ahmetfurkangursoy/EE464-TermProject/PCB/Altium.md

The PCB of the converter is designed via Altium Designer
