ahmetfurkangursoy/EE464-TermProject/Backflyp.PPTX

## BACKFLYP

Md Shazid Hasan - 1824572
Ahmet Furkan Gürsoy - 2375061

## Why Flyback

- Good Isolation
- Wide Input Range
- High Efficiency
- Fewer Component Comparing Other Topologies
- Many Design Guides

## Design Parameters

V_(Qmax) =V_(RO) + V_(in,max)
V_(RO) =V_(Qmax) − V_(in,max)
V_(RO) =42−18=24V
V_(RO) =(N_1)/(N_2)∗V_(out) →(N_1)/(N_2)=1/2

## Slide 4

- L_p =(V_(in,min)^2 ∗D_(max)^2 ∗eff)/(2∗P_(out) ∗f_(sw))=((12∗0.5)^2 ∗0.9)/(2∗48∗60kHz)=5.625 μH
- I_(p,peak) =(V_(in) ∗D_(max))/(L_p ∗f_(sw))=(12∗0.5)/(5.625μ∗60k)=17.78 A
- I_(p,rms) =17.78∗√(0.5/3)=7.26 A
- I_(s,peak) =17.78/2=8.89 A
- I_(s,rms) =8.89∗√(0.5/3)=3.63 A

## Magnetic Design

J_(rms) =5A/(mm^2) B_(sat) =0.2 T k_(cu) =0.3
WaAc=48/(2∗0.3∗5∗0.2∗60k)∗100=0.133 cm^4
- 00K2510E090 Core Values;
A_w =77.8 mm^2 A_e =38.5 mm^2
WaAc=77.8 mm^2 ∗ 38.5 mm^2 =0.3 cm^4

## Slide 6

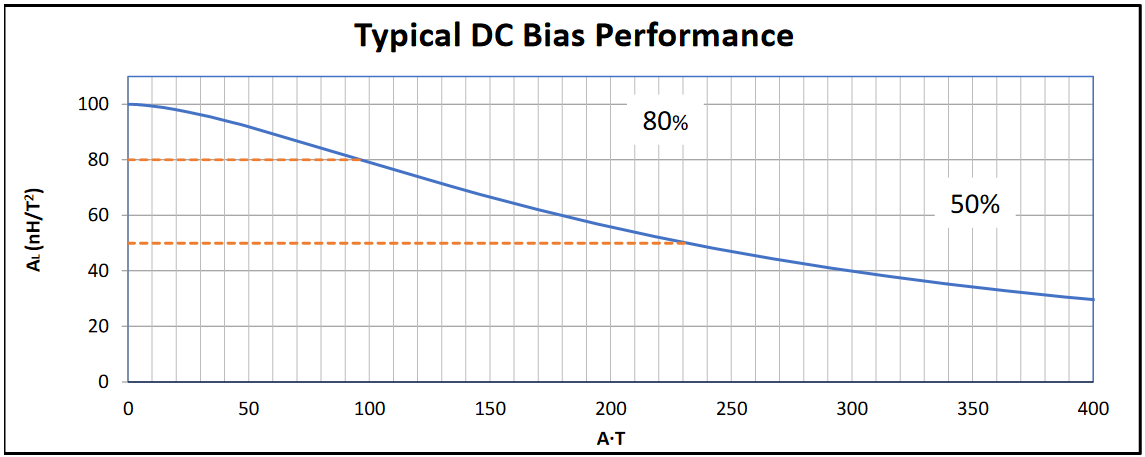
[picture p1: figure]

L_p =L_m =5.625 μH
N_p =8
A.T=7.26∗8≈60 → A_L ≈90 (nH)/(T^2)
L_p =L_m =8^2 ∗90∗10^(−3) =5.76 μH
N_s =2∗N_p =2∗8=16

## Slide 7

A_(pri) =7.26/5=1.452 mm^2 A_(sec) =3.63/5=0.726 mm^2
n_(pri) =1.452/0.205≈7 n_(sec) =0.726/0.205≈4

## Semiconductors

- FQP30N6;
V_(ds) =60V I_D =30A R_(ds(on)) =40mΩ Q_g =19nC R_(θjc) =1.9(℃)/W
- MBR20100;
V_(RRM) =100V I_F =10A V_F =0.8V R_(θjc) =2(℃)/W

## Losses

MLT=2π(E−F)/2=39.11 mm
R_(pri) =(8∗39.11∗10^(−3) ∗84.198∗10^(−3))/7=3.76 mΩ
R_(sec) =(16∗39.11∗10^(−3) ∗84.198∗10^(−3))/4=13.17 mΩ
P_(cu) =7.26^2 ∗3.76∗10^(−3) +3.63^2 ∗13.17∗10^(−3) =370.7 mW
P_(core) =aB^b f^c
P_(core) =46.32∗0.2^1.988 ∗60^1.541 =1.038 W

## Slide 10

P_(cond,MOS) =(17.78/4)^2 ∗0.04=0.79 W
P_(sw,MOS) =V_(in) ∗I∗f∗(t_r +t_f )
P_(sw,MOS) =18∗17.78/4∗60∗10^3 ∗(85+40)∗10^(−9) =0.6 W
P_(cond,max,Diode) =8.89/4∗0.8=1.78 W
Snubber Loss?

## Thermal Calculations

- Assumptions;
V_a =25℃ Thermal Grase=0.5(℃)/W Heatsink=8(℃)/W
R_(θjc,sw) =1.9(℃)/W R_(θjc,diode) =2(℃)/W
T_(j,sw) =25+(0.79+0.6)W∗(1.9+0.5+8)(℃)/W=39.5 ℃
T_(j,diode) =25+1.78W∗(2+0.5+8)(℃)/W=43.7 ℃
No Need Fans for Semi-Conductors !

## Slide 12

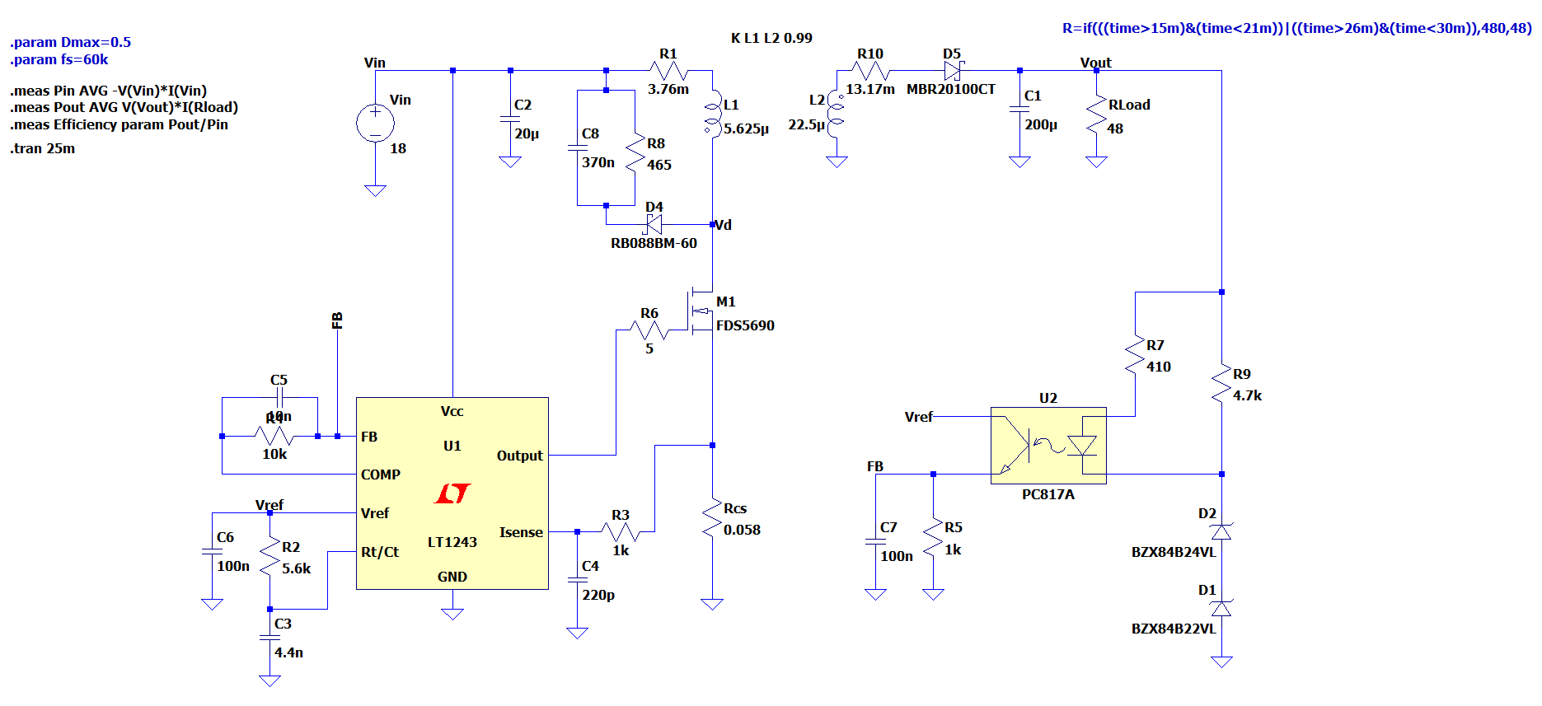
[picture p2: figure]
metin, diyagram, ekran görüntüsü, çizgi içeren bir resim Açıklama otomatik olarak oluşturuldu

## UC3843

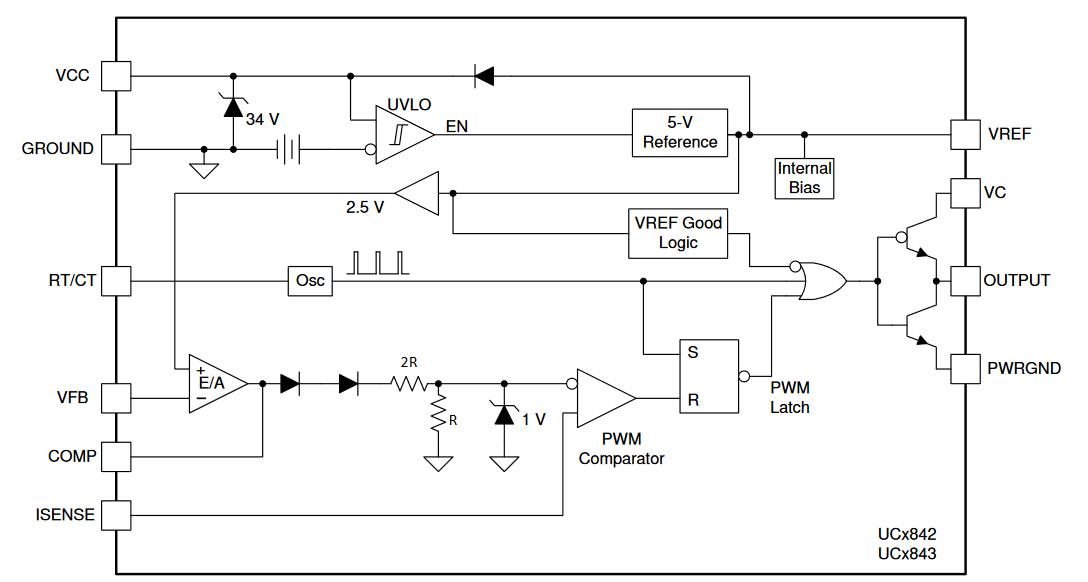
[picture p3: figure]
diyagram, plan, metin, teknik çizim içeren bir resim Açıklama otomatik olarak oluşturuldu

- 12-28V Input
- Current Mode Control
- Up to 500 kHz
- No Need for Additional Gate Driver

## UC3843

## 18V-100% Load

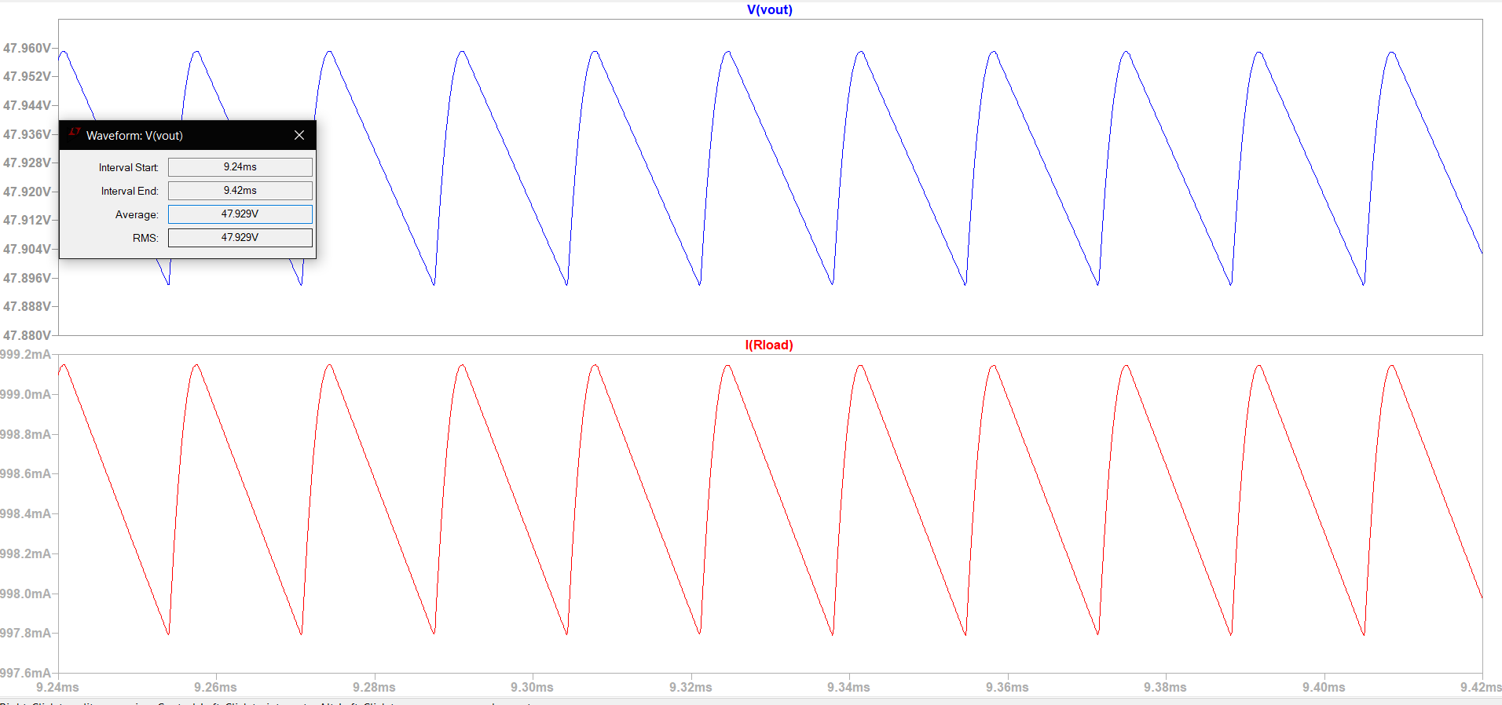
[picture p4: figure]
metin, ekran görüntüsü, öykü gelişim çizgisi; kumpas; grafiğini çıkarma, sayı, numara içeren bir resim Açıklama otomatik olarak oluşturuldu

## Slide 16

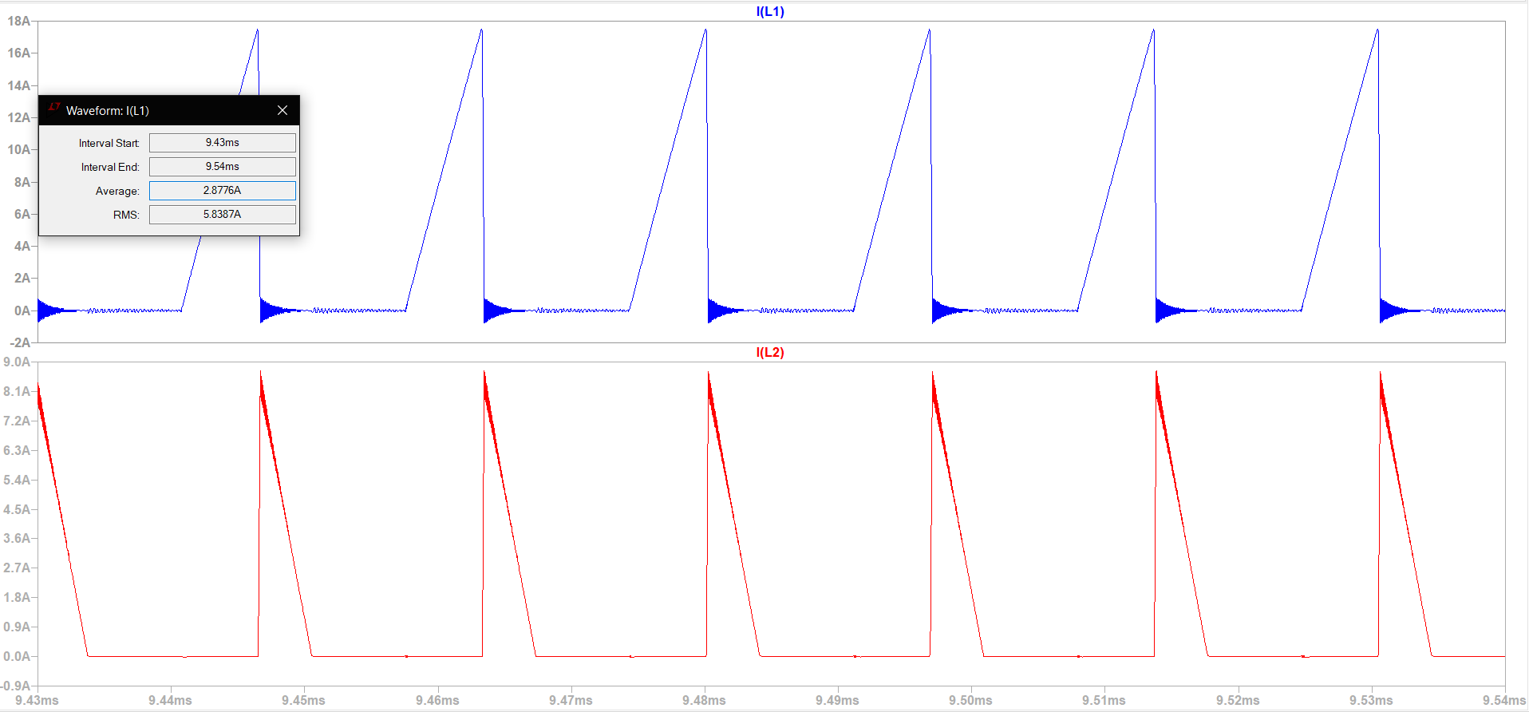
[picture p5: figure]
metin, ekran görüntüsü, diyagram, öykü gelişim çizgisi; kumpas; grafiğini çıkarma içeren bir resim Açıklama otomatik olarak oluşturuldu

## Slide 17

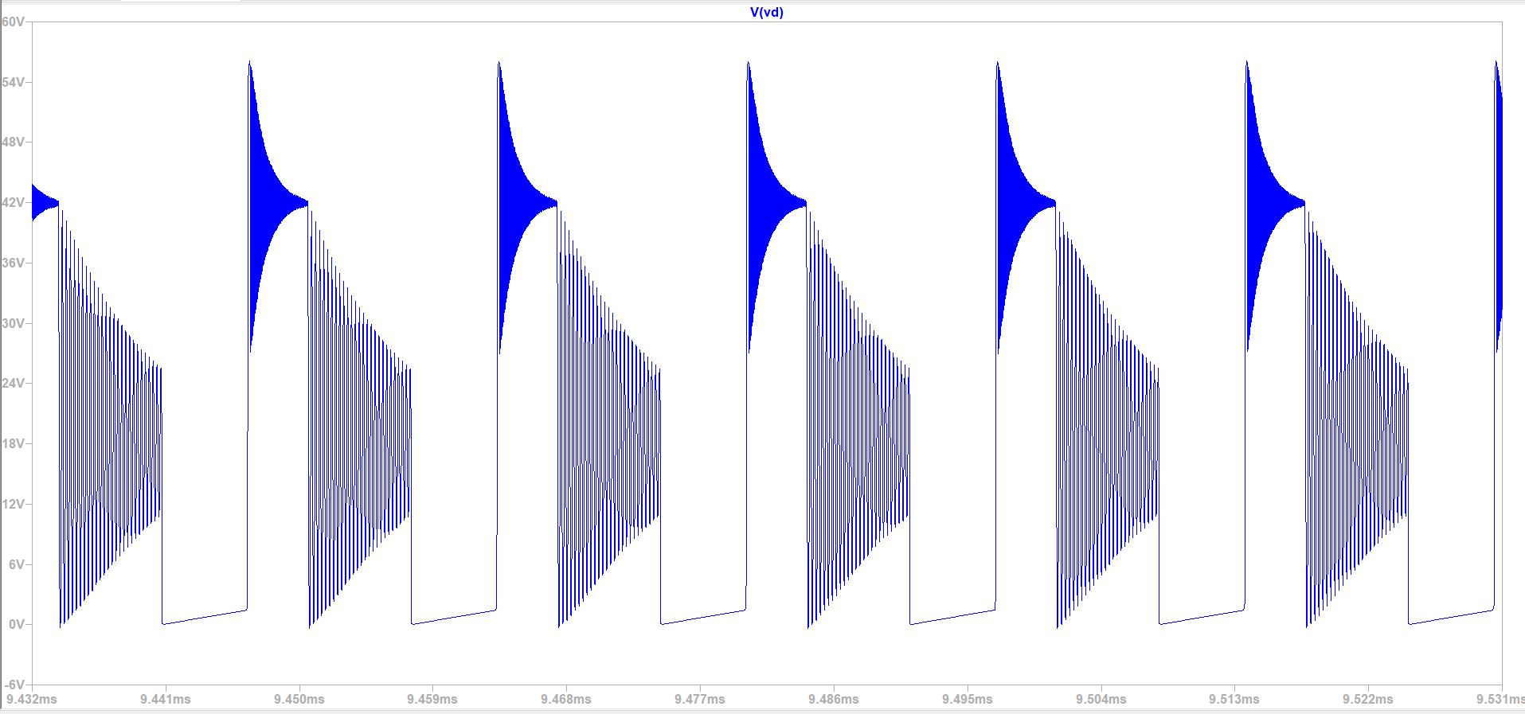
[picture p6: figure]
ekran görüntüsü içeren bir resim Açıklama otomatik olarak oluşturuldu

## Slide 18

Pin | 55.36 W
Pout | 47.86 W
Efficiency | 86.45%

## 12V - 25% Load

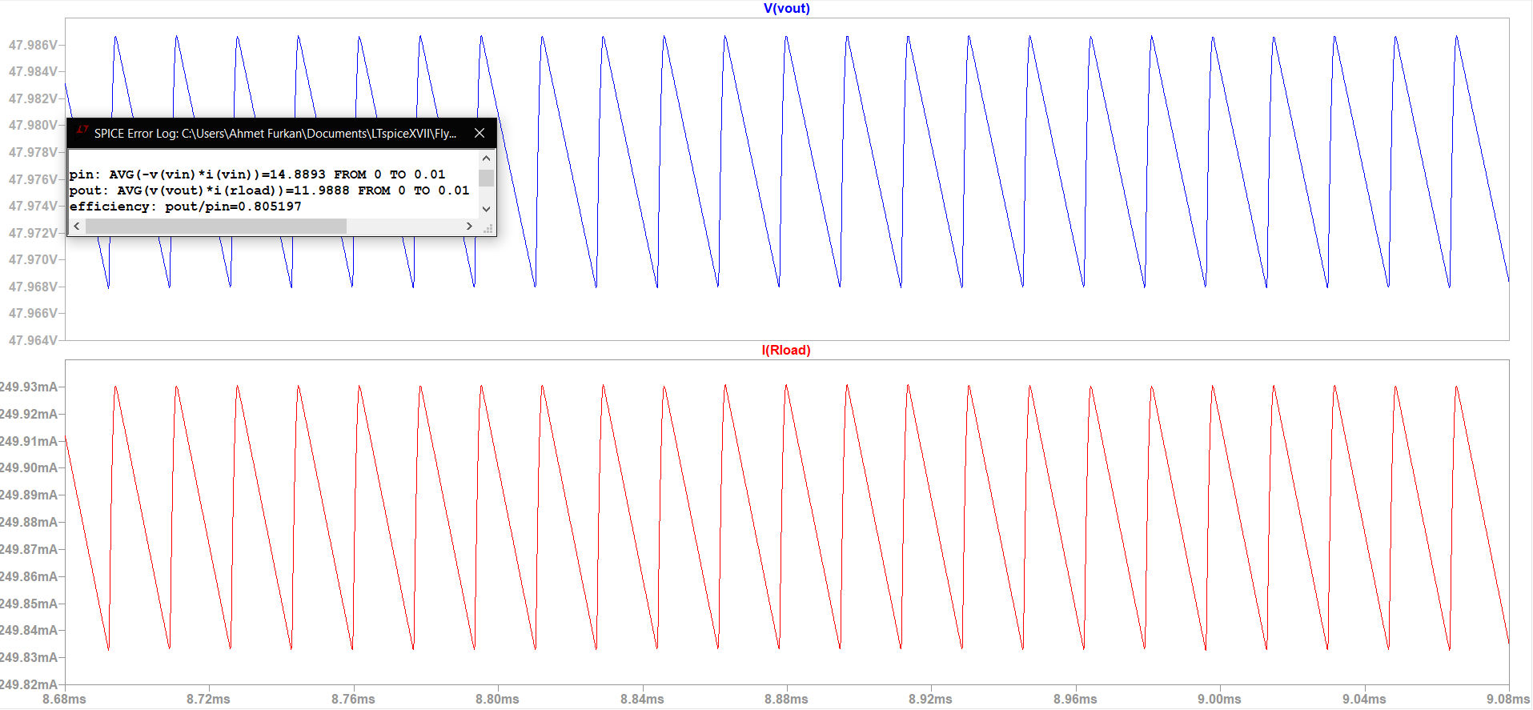
[picture p7: figure]
metin, ekran görüntüsü, yazı tipi, sayı, numara içeren bir resim Açıklama otomatik olarak oluşturuldu

## Instant Load Change

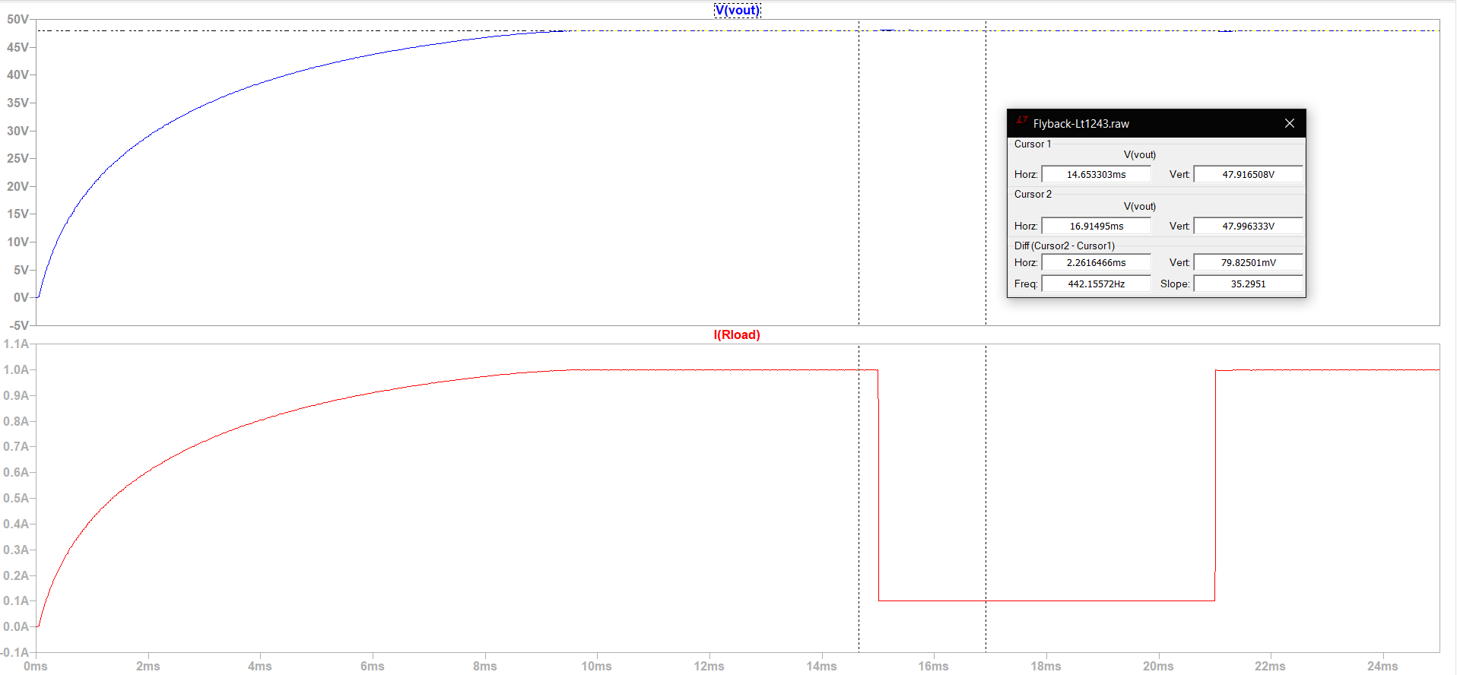
[picture p8: figure]
metin, ekran görüntüsü, sayı, numara, diyagram içeren bir resim Açıklama otomatik olarak oluşturuldu

## Instant Input Change

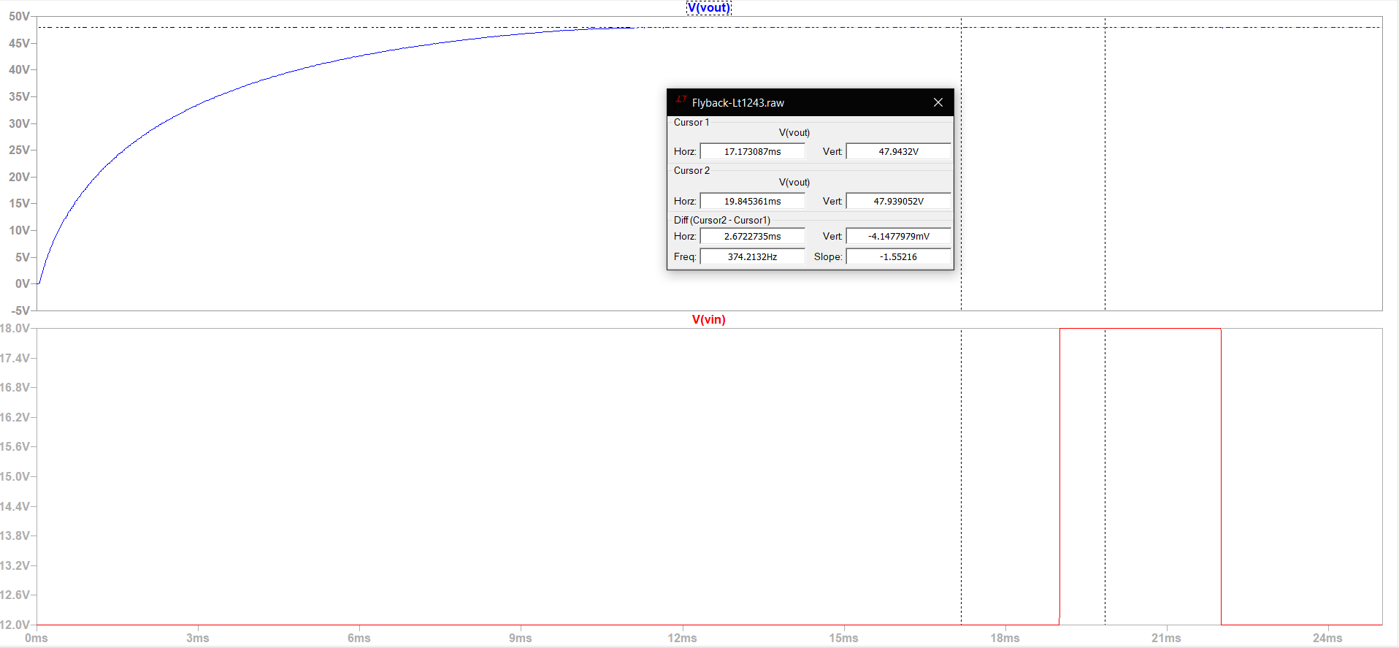
[picture p9: figure]
metin, ekran görüntüsü, sayı, numara, yazılım içeren bir resim Açıklama otomatik olarak oluşturuldu

## Possible Bonuses

- Single Supply
- Current Mode Control
- Efficiency
- Analog Controller IC
- PCB
- Industrial Design

## Questions

- What would happen if we overdesign using one of the large cores (00K3515E090) in the lab?
- What would happen if we put a large core into a small coil former?
- We get higher efficiency (87.27%) at 100kHz in simulation. In practice, if we use the 24 awg cable at 100 kHz, will we lose too much because of the skin depth?
