ahmetfurkangursoy/EE464-TermProject/EE464 Project Report of Backflyp.pdf

EE 464

# STATIC POWER CONVERSION-II

# Fall 2022-2023

# Backflyp

# Term Project Report

## Md Shazid Hasan - 1824572

## Ahmet Furkan Gürsoy - 2375061

Table of Contents

Introduction

In this project, it is required to design a converter that converts 12V-18V DC to 48V

DC with 48W power rating. The flyback converter topology was chosen because of the

abundance of resources and guides at the design point. In order to receive a plus bonus from

the project, at least 80% efficiency must be achieved. Therefore, considering its efficiency

advantage, it was decided to operate the converter in DCM mode. This report presents the

converter's design, manufacturing processes, simulation and practical test results.

Design Process

By aiming 90% percent efficiency and 0.5 max duty cycle, theoritical calculations are

conducted.

LP =

(12 ∗ 0.5)

2
∗ 0.9
2 ∗ 48 ∗ 60kHz = 5.625 μH

Ip,peak =

12 ∗ 0.5
5.625μ ∗ 60kHz = 17.78A

Ip,rms = 17.78√
0.5
3

= 7.26A

Is,peak =

17.78
2

= 8.89A

Is,rms = 8.89√
0.5
3

= 3.63A

Transformer is designed according to below parameters;

Jrms = 4

A
mm²

Bsat = 0.2T kcu = 0.3

From area product formula;

WaAc =

48
2 ∗ 0.3 ∗ 4 ∗ 0.2 ∗ 60k

∗ 100 = 0.167 cm⁴

From the lab inventory, 00K3515E090 core is chosen with area values;

Aw = 151mm² Ae = 84mm²

WaAc = 151mm²

∗ 84mm² = 1.27 cm⁴

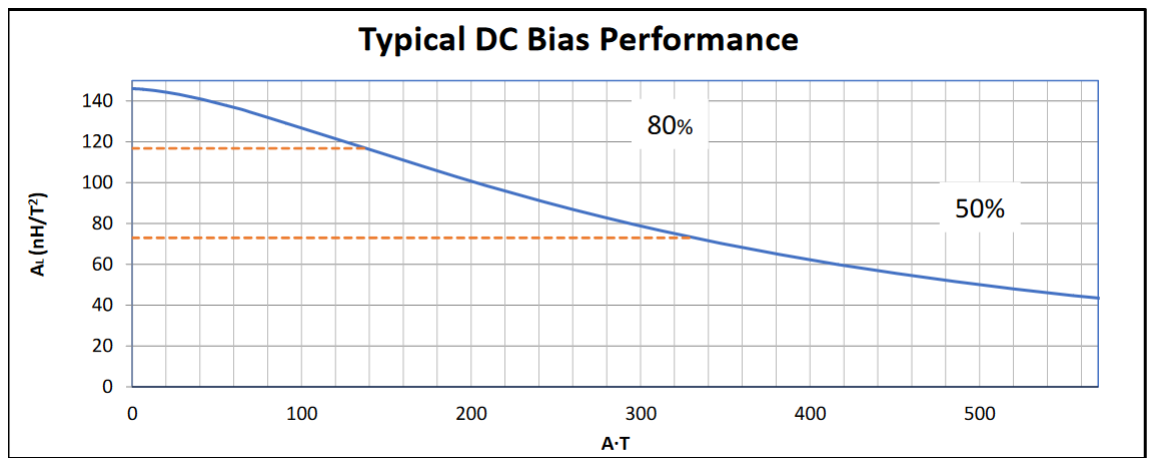
[picture p10: figure]

Figure 1. AL Value Graph of the Core

The required inductance value is calculated before as Lp = Lm = 5.625 μH. By looking

Figure1 the primary winding value is estimated as Np = 7.

A. T = 7.26 ∗ 7 ≈ 50 → AL ≈ 140 nH/T

2

Lp = Lm = 7

2

∗ 140 ∗ 10⁻³ = 6.86 μH

Ns = 2 ∗ NP = 2 ∗ 7 = 14

For winding cables;

Apri =

7.26
4

= 1.815mm² Asec =

3.63
4

= 0.908mm²

Figure 2. Winding Cable Parameters

npri =

1.815
0.205 = 8.85 ≈ 9 nsec =

0.908
0.205 = 4.43 ≈ 5

kcu =

9 ∗ 0.205mm²

∗ 7 + 5 ∗ 0.205mm²
∗ 14
151 mm² | = 0.18

The transformer is wound according to the above calculations. The primary of the

transformer is measured as 6μH and the secondary is 23.9μH. In addition, there is a leakage of

approximately 6.5% (390nH) in the transformer. Due to this leakage and high current ripple, a

sudden voltage jump occurs when the switch is closed. When it is desired to keep this jump at

80V levels, a very high level of loss occurs in the RCD snubber. Therefore, it was decided to keep the drain voltage at 150V. In addition, the RC snubber is placed in order to reduce the

switching losses.

IRFP250N MOSFET is used to switch at the specified voltage level. The reason for

using this MOSFET is that it is the only MOSFET with sufficient rating in the personal

inventory. The important parameters of MOSFET are given in Table 1 below.

Table 1. IRFP250N Parameters

VDS | 200V
ID | 30A
RDS(on) | 0.075Ω
Qg | 123nC
RJC | 0.7 ˚C/W

At maximum condition, according to simulation, 6Arms passes through the switch. The

thermal resistances of thermal paste and heatsink are 0.5˚C/W and 9˚C/W respectively.

Pcond = 6

2
∗ 0.075 = 2.7W
Psw = 18 ∗ 6 ∗ 60 ∗ 10³

∗ (43 + 33) ∗ 10⁻⁹ = 0.49W

TJ = (2.7 + 0.49)W ∗ (0.7 + 0.5 + 9)˚

C
W

+ 25˚C = 57.5 ˚C

So, there will be no need for extra cooling operation with a fan.

UC3843 IC is used to control the converter. The IC is a current-mode analog PWM

controller. The IC can take input voltage up to 30V. Therefore, the input voltage can be

supplied directly to the IC. In addition, there is a totem-pole structure at the output of the IC.

Thus, the switch can be driven directly. In order to perform current-mode control, it is

necessary to read 1V from the sense leg of the IC. The current on the transformer climbs up to

about 20A at the maximum. Therefore, 50mohm is determined as the sense resistance. Sense

resistance is created by paralleling 2 of 0.1ohm 4W SMT resistors. In order to get isolated

feedback from the circuit output, PC817A optocoupler is used. 13V and 33V zener diodes are

used in the secondary part of the optocoupler. The primary part of the optocoupler is

connected to the IC by an RC compensation system.

At the output, allowable voltage ripple is 3% which is around 1.5V. With the

simulation results 200μF capacitance value is seemed enough to meet this condition. To

reduce the ESR effect of the capacitors 2x100μF capacitor used at the output. Also, although a

DC input is given from the input a 100μF capacitor is connected to input to supply instant

current demands. A 10k resistor is connected to output to discharge the output capacitances in

case no load. The values of the snubber capacitances and resitances are determined and tuned

through simulations. BOM list of the converter is presented below Table 2.

Table 2. BOM List of the Converter
Component | Description | Amount
UC3843A | Current-Mode PWM Controller | 1
00K3515E090 | Kool Mμ E Core | 2
PC817A | Optocoupler | 1
MBR10150 | 150V 10A Schottky Diode | 2
13V Zener | - | 1
33V Zener | - | 1
18V Zener | - | 1
IRFP250N | 200V 30A MOSFET | 1
100μF 63V Capacitor | Output Capacitors | 2
100μF 200V Capacitor | Input Capacitor | 1
10kΩ Resistor | - | 3
100 mΩ Resistor | 4W SMT Shunt Resistor | 2
1kΩ Resistor | - | 3
15R Resistor | Gate Resistance | 1
100kΩ Resistor | - | 1
5.6kΩ Resistor | - | 2
430R Resistor | - | 1
220pF Capacitor | - | 1
2.2nF Capacitor | - | 2
10nF Capacitor | - | 1
22nF Capacitor | - | 1
100 nF Capacitor | - | 3
470nF Capacitor | - | 1

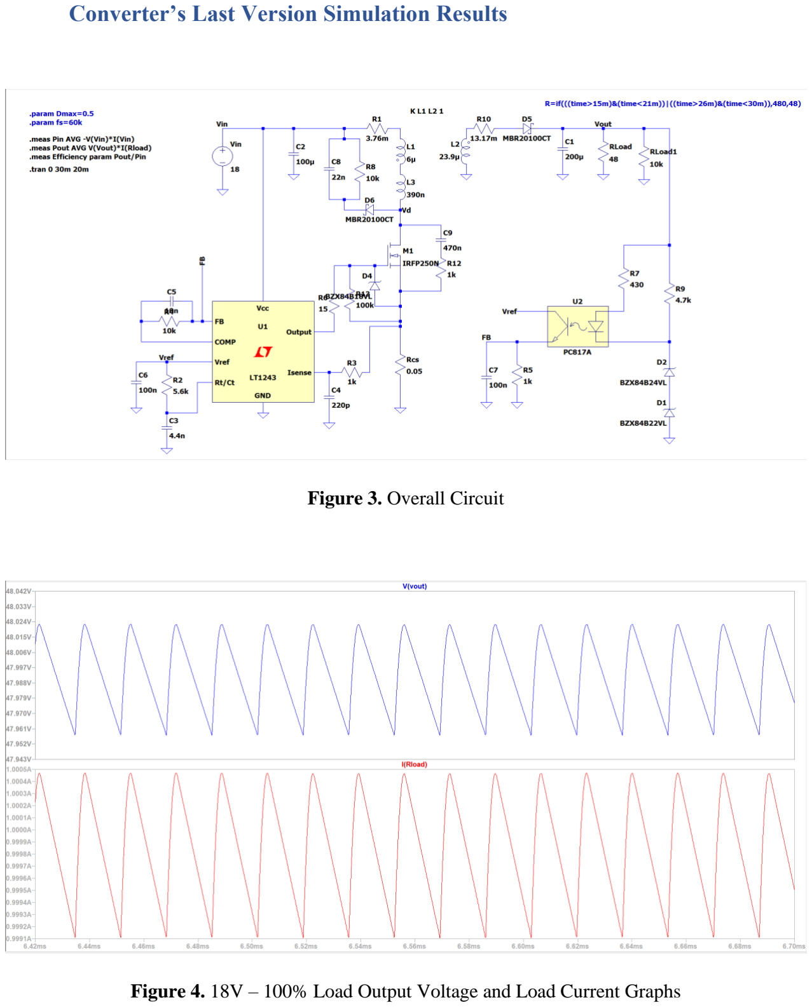
[picture p11: page 7]

Converter’s Last Version Simulation Results

Figure 3. Overall Circuit

Figure 4. 18V – 100% Load Output Voltage and Load Current Graphs

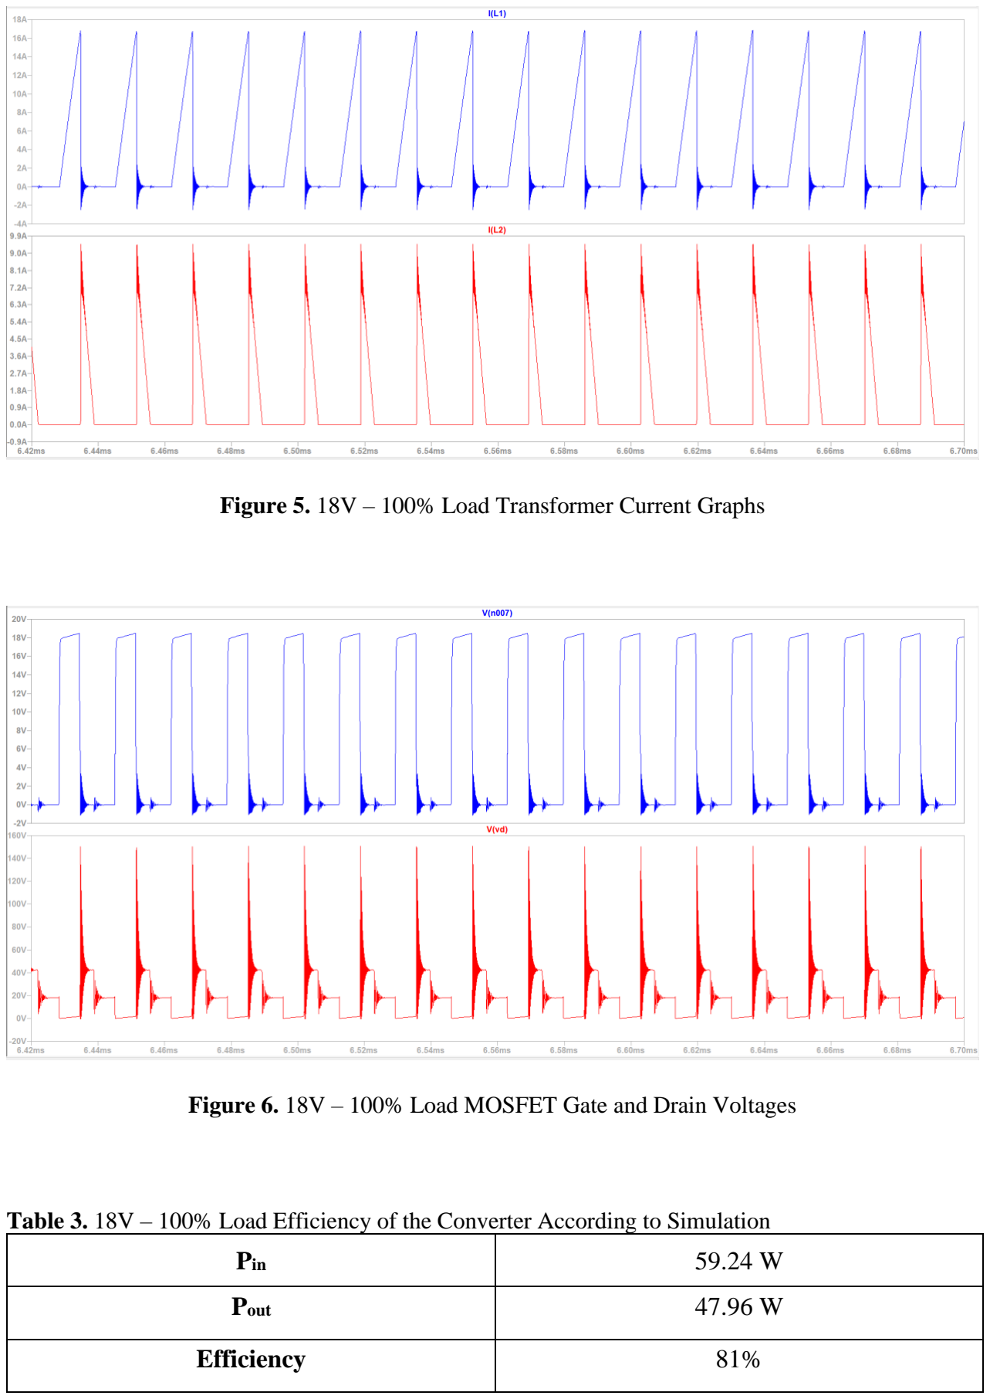
[picture p12: page 8]

Figure 5. 18V – 100% Load Transformer Current Graphs

Figure 6. 18V – 100% Load MOSFET Gate and Drain Voltages

Table 3. 18V – 100% Load Efficiency of the Converter According to Simulation
Pin | 59.24 W
Pout | 47.96 W
Efficiency | 81%

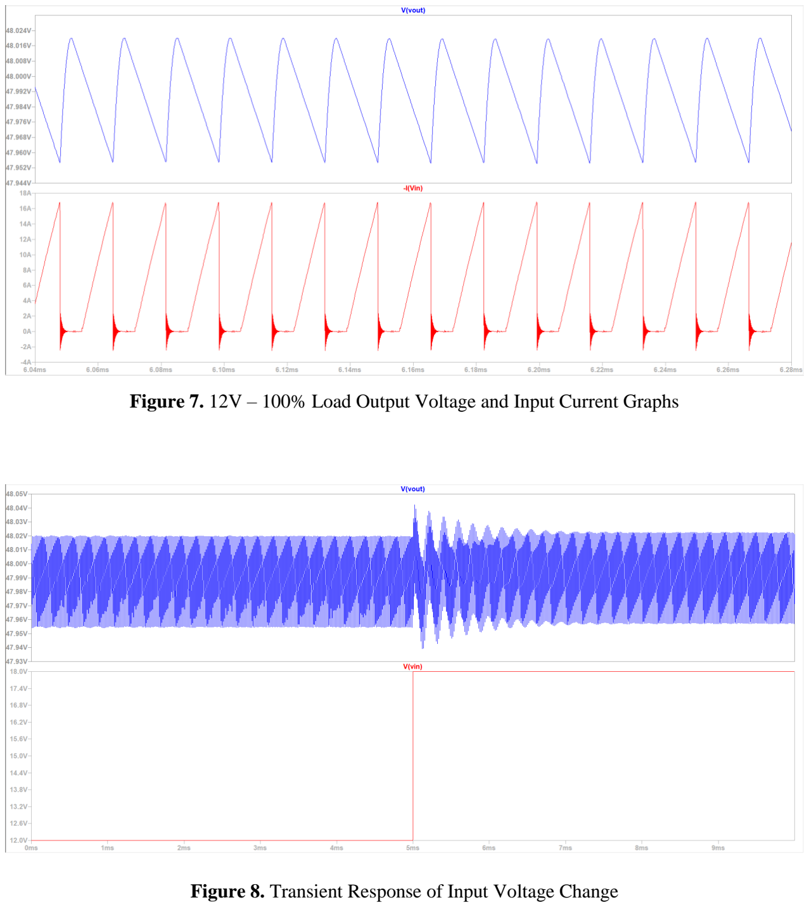
[picture p13: page 9]

Figure 7. 12V – 100% Load Output Voltage and Input Current Graphs

Figure 8. Transient Response of Input Voltage Change

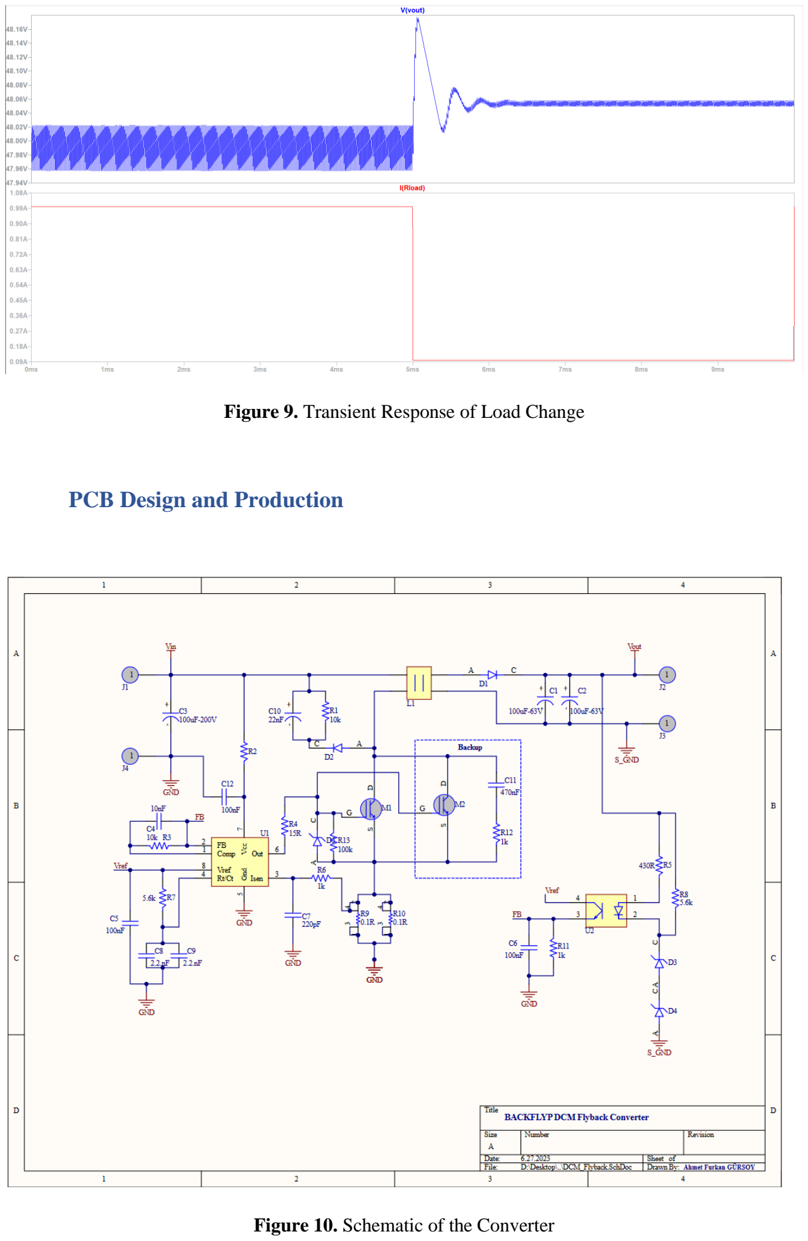
[picture p14: page 10]

Figure 9. Transient Response of Load Change

PCB Design and Production

Figure 10. Schematic of the Converter

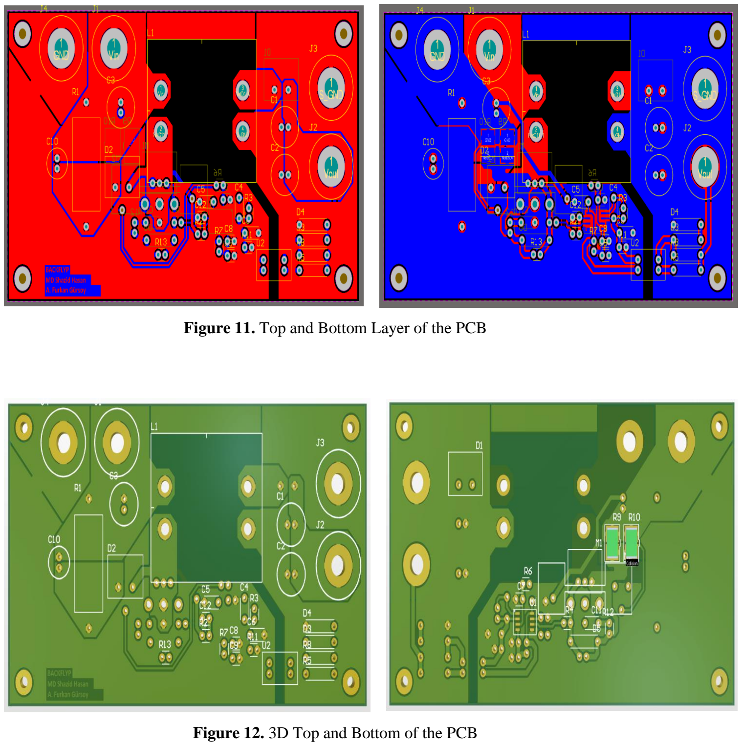
[picture p15: page 11]

Figure 11. Top and Bottom Layer of the PCB

Figure 12. 3D Top and Bottom of the PCB

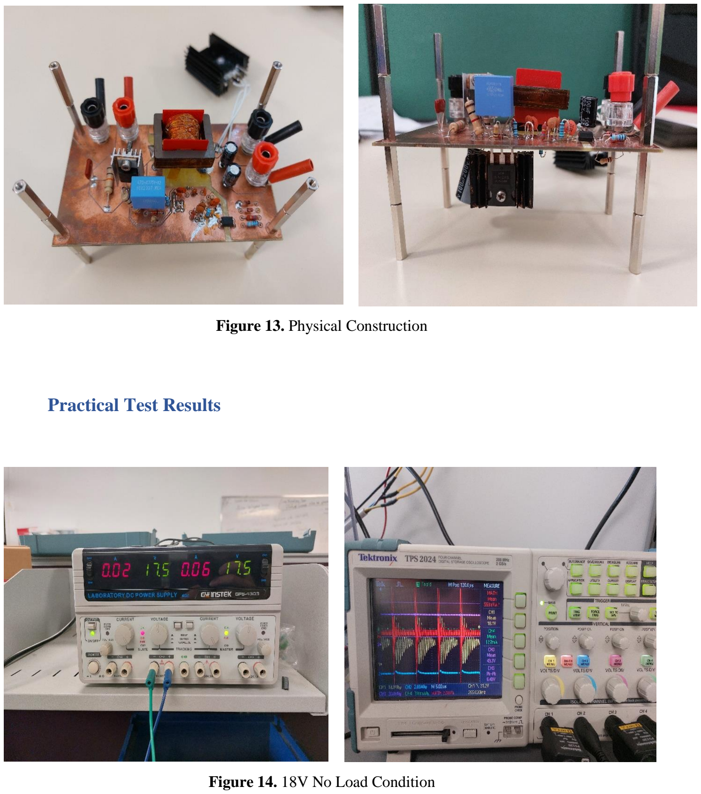
[picture p16: page 12]

Figure 13. Physical Construction

Practical Test Results

Figure 14. 18V No Load Condition

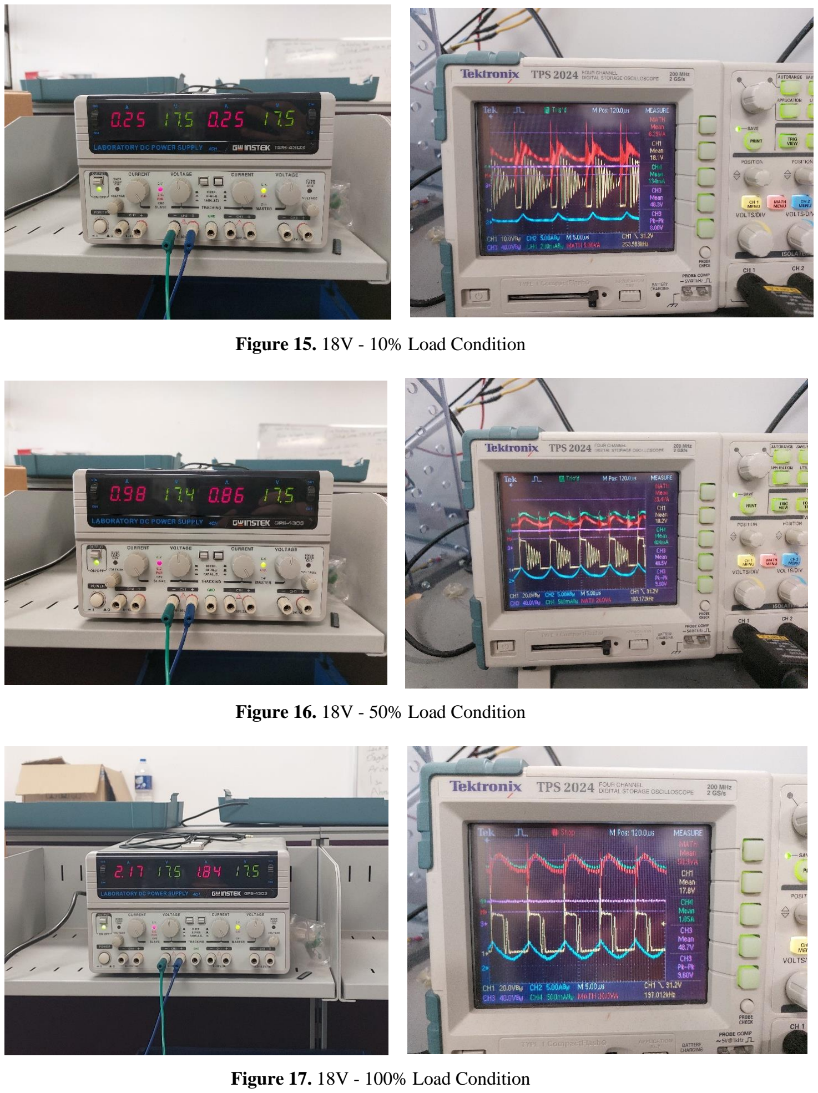
[picture p17: page 13]

Figure 15. 18V - 10% Load Condition

Figure 16. 18V - 50% Load Condition

Figure 17. 18V - 100% Load Condition

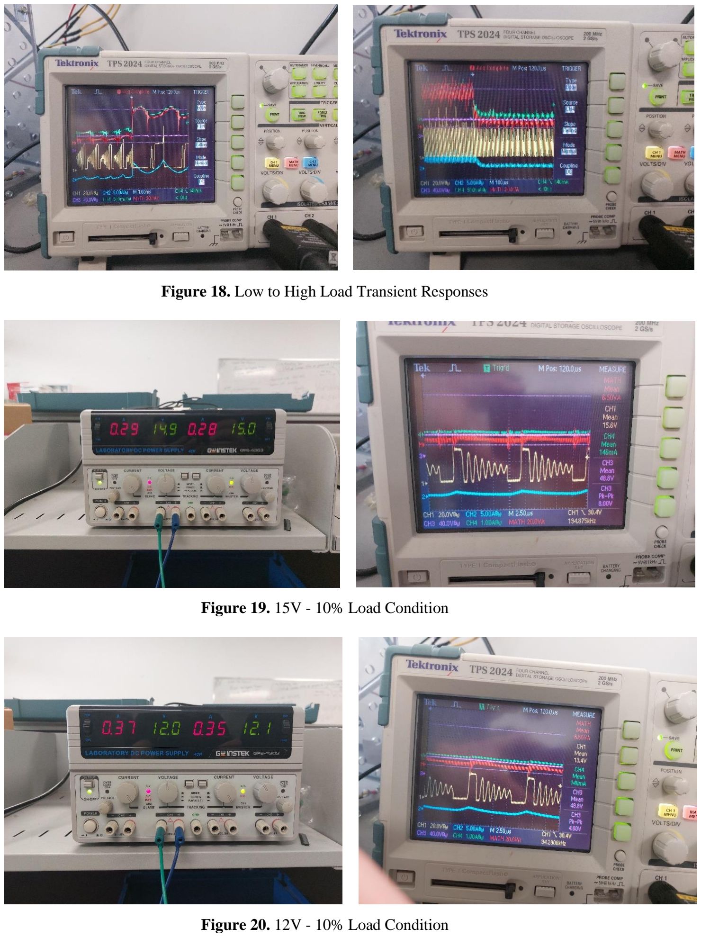
[picture p18: page 14]

Figure 18. Low to High Load Transient Responses

Figure 19. 15V - 10% Load Condition

Figure 20. 12V - 10% Load Condition

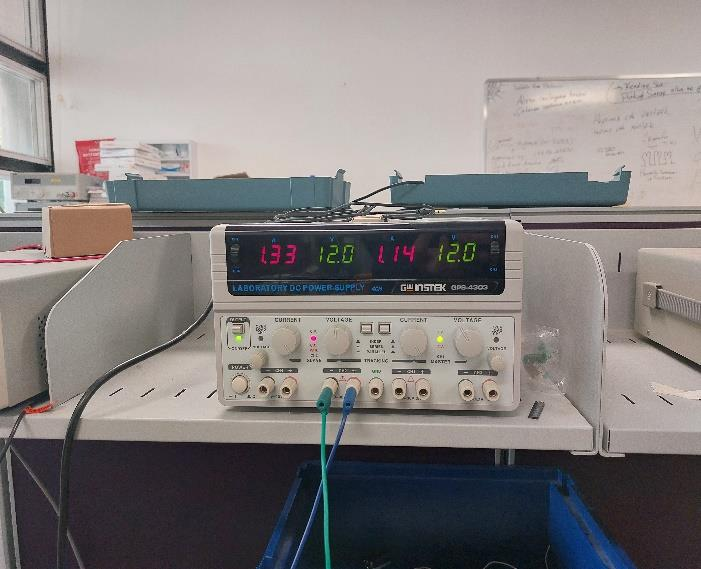
[picture p19: figure]
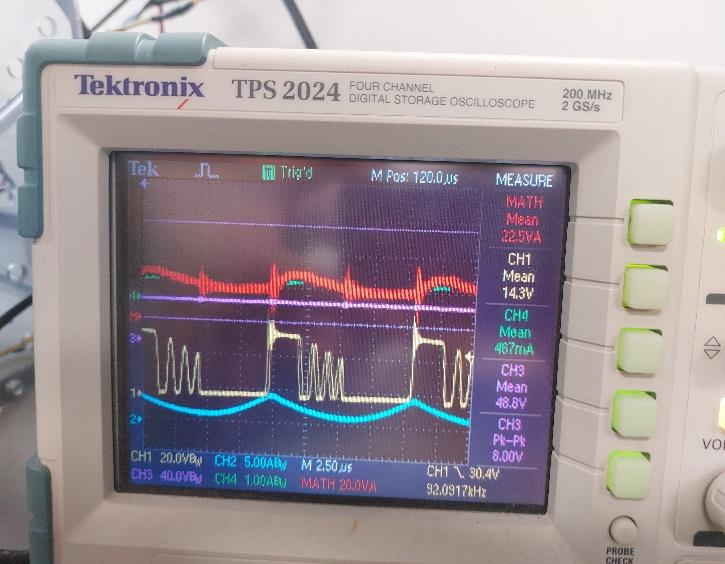
[picture p20: figure]

Figure 21. 12V - 50% Load Condition

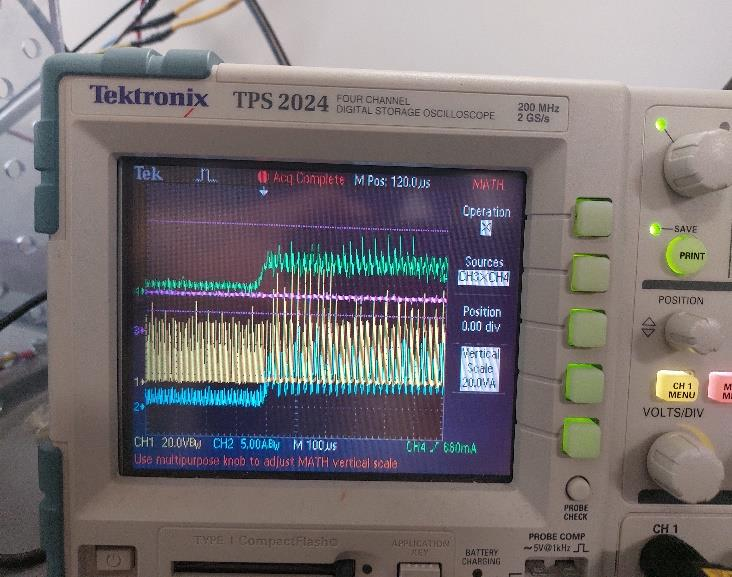
[picture p21: figure]
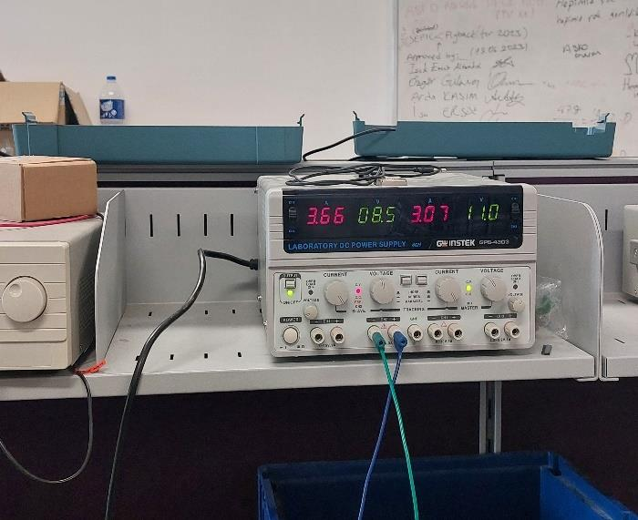
[picture p22: figure]

Figure 22. 12V - 100% Load Condition | Figure 23. 12V to 18V Transient Response

Test Results and Discrepancies Between Simulation and Practical Results

First of all, the circuit has generally performed correctly. Except for the 12V full load

option, it was able to provide the required voltage and load values. In the tests carried out at the

beginning, the input capacity was placed as 20uF 50V. While running the tests, the capacitor

exploded while operating at 18V - 60% load. The capacitor was predicted to explode due to

high current ripple and the capacitance was replaced with 100uF 200V. As seen in Figure 7,

although the circuit works correctly at 12V - 100% load in the simulation, it is observed that

the voltage at the input source decreases in the practical circuit in Figure 22. In the simulation,

the efficiency was calculated as 81% at 18V - 100% load, as seen in Table 3. However,

efficiency in the practical circuit calculated as;

η =

47.8 ∗ 1.05
17.5 ∗ 4.01 ∗ 100 = 71.5%

Cable and core losses are not taken into account in the simulation. In addition, the

converter, which works with 60kHz in theory and simulation, works with 72kHz in practice.

This situation is predicted to increase the switching losses and AC resistance losses. The

difference in yield is thought to be due to these reasons. Although not presented in the results,

there was no component exceeding 65 ˚C in temperature measurements at 18V - 100% load.

Conclusion

This paper was written to cover the design, production, simulation and testing phases

of a Flyback converter operating in DCM mode. Inconsistencies in theory, simulation, and

test points are noted in the report. Theoretical magnetic design, practical transformer

production and PCB design are experienced throughout the design and production processes.

During the test processes, problems that were not visible in the simulation that the high

current ripple created were understood. In addition, it has been seen that DCM is not as

advantageous as described in the design guides in terms of efficiency.
