ahmetfurkangursoy/EE464-TermProject/Magnetic Design and Simulation Report of Backflyp.pdf

EE 464

# STATIC POWER CONVERSION-II

# Fall 2022-2023

# Backflyp

# Term Project Magnetic Design and Simulation Report

## Md Shazid Hasan - 1824572

## Ahmet Furkan Gürsoy - 2375061

Introduction

In this project, it is required to design a converter that converts 12V-18V DC to 48V

DC with 48W power rating. The flyback converter topology was chosen because of the

abundance of resources and guides at the design point. In order to receive a plus bonus from

the project, at least 80% efficiency must be achieved. Therefore, considering its efficiency

advantage, it was decided to operate the converter in DCM mode. In this report, theoretical

calculations of the converter and simulations of ideal and non-ideal states are presented.

Design Procedure

Since the importance of the use of the materials in the inventory was understood in the

project carried out last year, it was decided to use the IRF540N MOSFET(100V 28A), one of

the MOSFETs in the inventory. In order to stay in the safe zone, the voltage on the MOSFET

was decided to be 42V in the loop where the switch is closed. After examining the design

guides, it was decided that maximum duty cycle of 0.5 would be appropriate.

VQmax = VRO + Vin,max

VRO = VQmax − Vin,max

VRO = 42 − 18 = 24V

VRO =

N1
N2

∗ Vout →

N1
N2

=

1
2

Pin =

Pout
0.9

=

48
0.9

= 53.33W

Calculations were made according to the efficiency of 0.9, since it is estimated that the

efficiency will be lower than the calculated one in practice. The operating frequency is

determined as 60 kHz in order to avoid skin depth and to be able to use thicker cable while

winding transformer.

LP =

(12 ∗ 0.5)

2
∗ 0.9
2 ∗ 48 ∗ 60kHz = 5.625 μH

Ip,peak =

12 ∗ 0.5
5.625μ ∗ 60kHz = 17.78A

Ip,rms = 17.78√
0.5
3

= 7.26A

Is,peak =

17.78
2

= 8.89A

Is,rms = 8.89√
0.5
3

= 3.63A

At the end of the researches, it was decided that the magnetic design parameters should be as

follows. The current density is taken higher than normal because the number of cables that need

to be paralleled for transformer winding is wanted to be reduced. If it is detected that the

transformer is overheating, an external cooling operation will be performed.

Jrms = 5

A
mm²

Bsat = 0.2T kcu = 0.3

From area product formula;

WaAc =

48
2 ∗ 0.3 ∗ 5 ∗ 0.2 ∗ 60k

∗ 100 = 0.133 cm⁴

In the researches, it has been seen that E cores are frequently used with flyback. Although it

was initially thought to use a gapped ferrite core, it was decided that a kool mu core would be

more suitable instead of making gap calculations. From the catalog of Magnetics,

00K2510E090 core is chosen with area values;

Aw = 77.8mm² Ae = 38.5mm²

WaAc = 77.8mm²

∗ 38.5mm² = 0.3 cm⁴

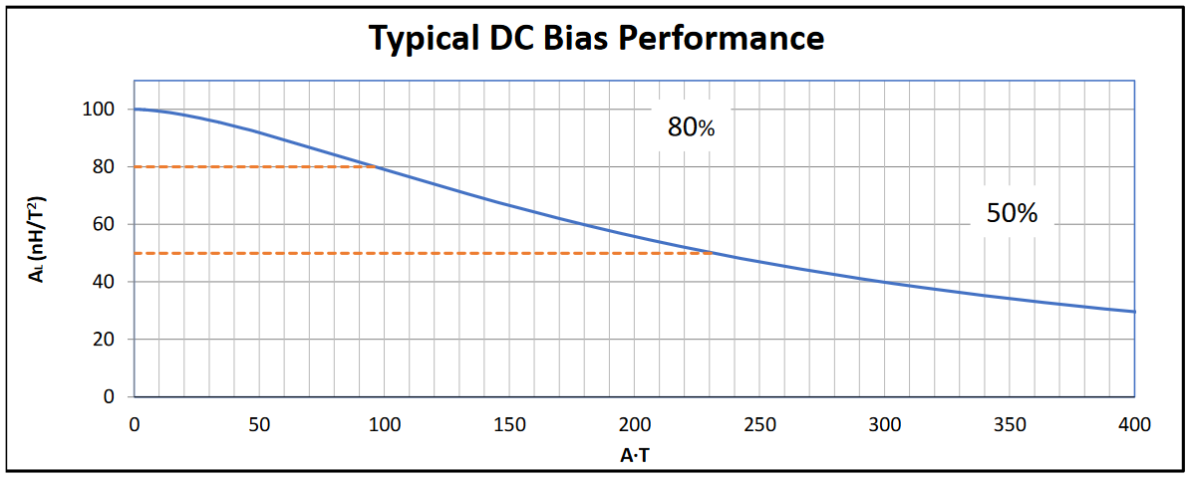
[picture p23: figure]

Figure 1. AL Value Graph of the Core

The required inductance value is calculated before as Lp = Lm = 5.625 μH. By looking

Figure1 the primary winding value is estimated as Np = 8.

A. T = 7.26 ∗ 8 ≈ 60 → AL ≈ 90 nH/T

2

Lp = Lm = 8

2

∗ 90 ∗ 10⁻³ = 5.76 μH

Estimation is verified then;

Ns = 2 ∗ NP = 2 ∗ 8 = 16

For winding cables;

Apri =

7.26
5

= 1.452mm² Asec =

3.63
5

= 0.726mm²

Figure 2. Winding Cable Parameters

npri =

1.452
0.205 = 7.07 ≈ 7 nsec =

0.726
0.205 = 3.54 ≈ 4

kcu =

7 ∗ 0.205mm²

∗ 8 + 4 ∗ 0.205mm²
∗ 16
77.8 mm² | = 0.316

Fill factor is verified too, then cable losses are calculated;

Rpri =

6 ∗ 29.06 ∗ 10⁻³

∗ 84.198 ∗ 10⁻³
7

= 2.1 mΩ

Rsec =

12 ∗ 29.06 ∗ 10⁻³

∗ 84.198 ∗ 10⁻³
4

= 3.67 mΩ

Pcu = 7.26²

∗ 2.1 ∗ 10⁻³ + 3.63²

∗ 3.67 ∗ 10⁻³ = 159 mW

Core loss is calculated according to below formula;

Pcore = aB

bf

c

Constants given from manufacturer are a = 46.32 b = 1.988 c = 1.541 then;

Pcore = 46.32 ∗ 0.2

1.988 ∗ 60¹.541 = 1.038 W

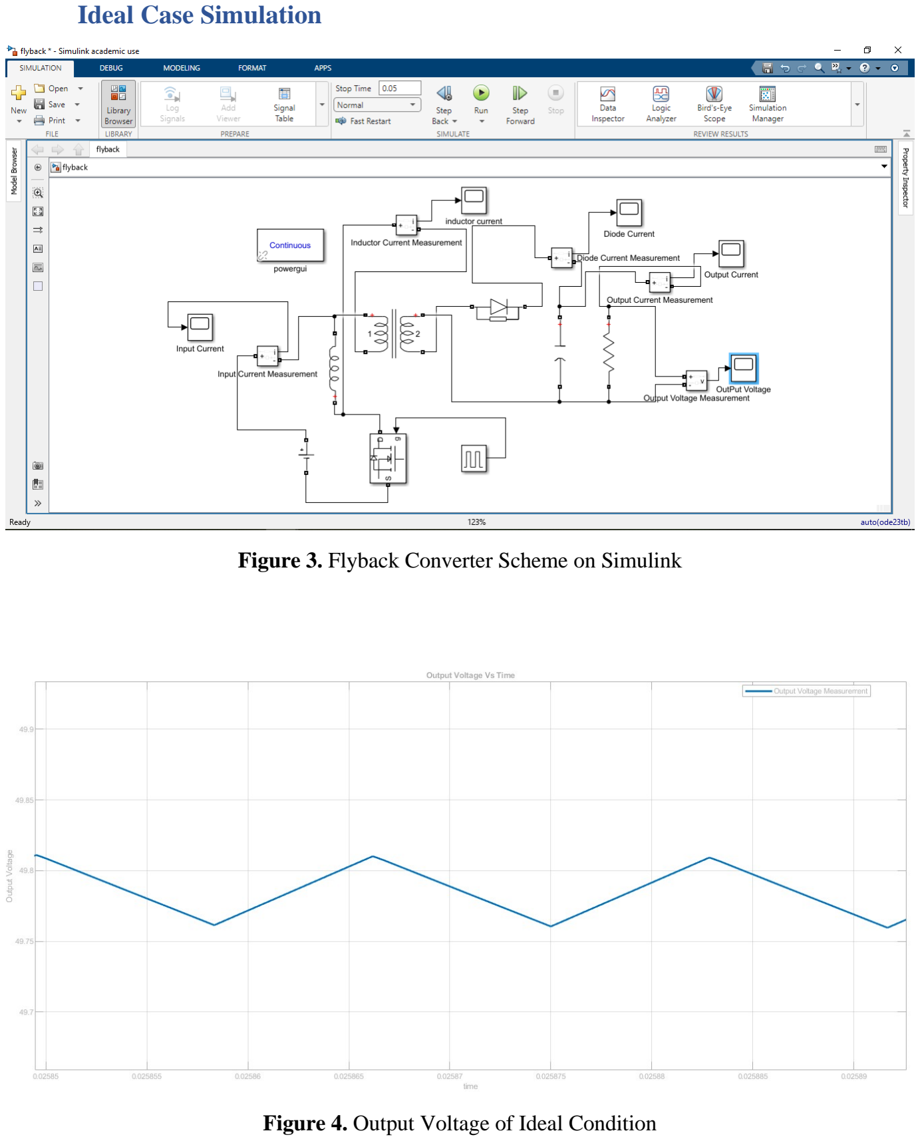
[picture p24: page 5]

Ideal Case Simulation

Figure 3. Flyback Converter Scheme on Simulink

Figure 4. Output Voltage of Ideal Condition

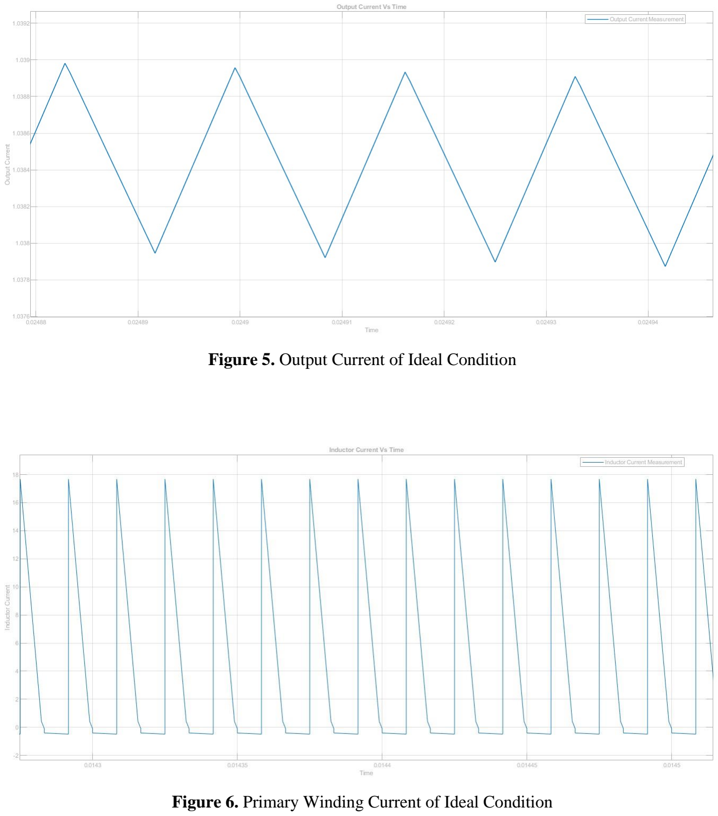
[picture p25: page 6]

Figure 5. Output Current of Ideal Condition

Figure 6. Primary Winding Current of Ideal Condition

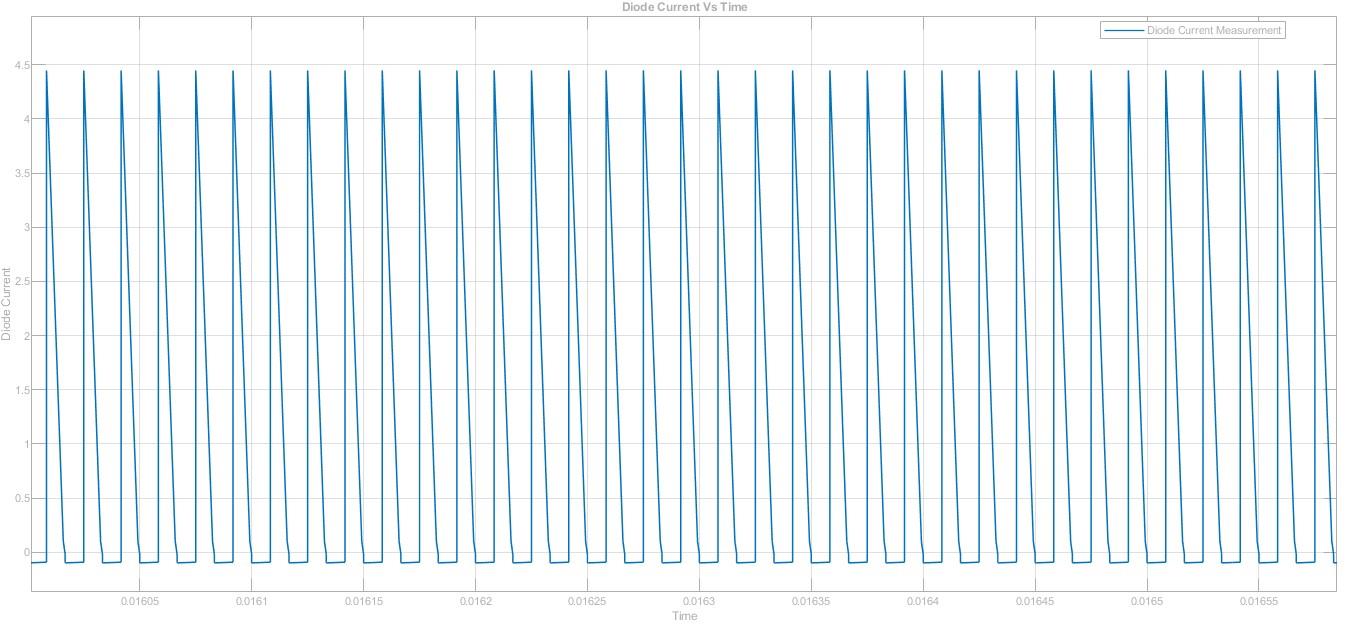
[picture p26: figure]

Figure 7. Output Diode Current of Ideal Condition

Efficiency Calculation

Pcond,MOS = Ip

2

∗ Rds = 7.26²
∗ 0.044 = 2.32W

Psw,MOS = Vin ∗ I ∗ f ∗ (tr + tf) = 18 ∗ 7.26 ∗ 60kHz ∗ (35 + 35)ns = 0.55W

Pcond,Diode = Is ∗ Vd(on) = 3.63 ∗ 0.84 = 3.05W

Pcore = 46.32 ∗ 0.2

1.988 ∗ 60¹.541 = 1.038 W

Pcu = 7.26²

∗ 2.1 ∗ 10⁻³ + 3.63²

∗ 3.67 ∗ 10⁻³ = 159 mW

Ploss = 2.32 + 0.55 + 3.05 + 1.04 + 0.16 = 7.12W

Pin = Pout + Ploss = 48 + 7.12 = 55.12W

η =

48
55.12 = 87.27%

Simulation of Non-Ideal Circuit

LTSpice program is used to simulate the converter with realistic non-ideal components.

IRF1310 MOSFET is used as the equivalent of the MOSFET in the inventory. Appropriate ones

from the Spice library were used for Zener and Schottky diodes. It is decided to use TI's UC3843

IC for the switching process. This IC is a current mode pwm controller. LT1243, which is the

equivalent of this IC in LTSpice, is used for simulation. The feedback loop in the circuit is

established using optocoupler. The op-amp compensation network was set up using the

common values and gave the appropriate result. In the course of the project, the working

mechanism of the compensation network will be learned and these values will be updated for

the most appropriate situation. The snubber circuit was created using TI's Power Stage Designer

program. The values of this circuit will also be updated for the optimal case. In the coming

period the focus will be on increasing the efficiency of the converter.

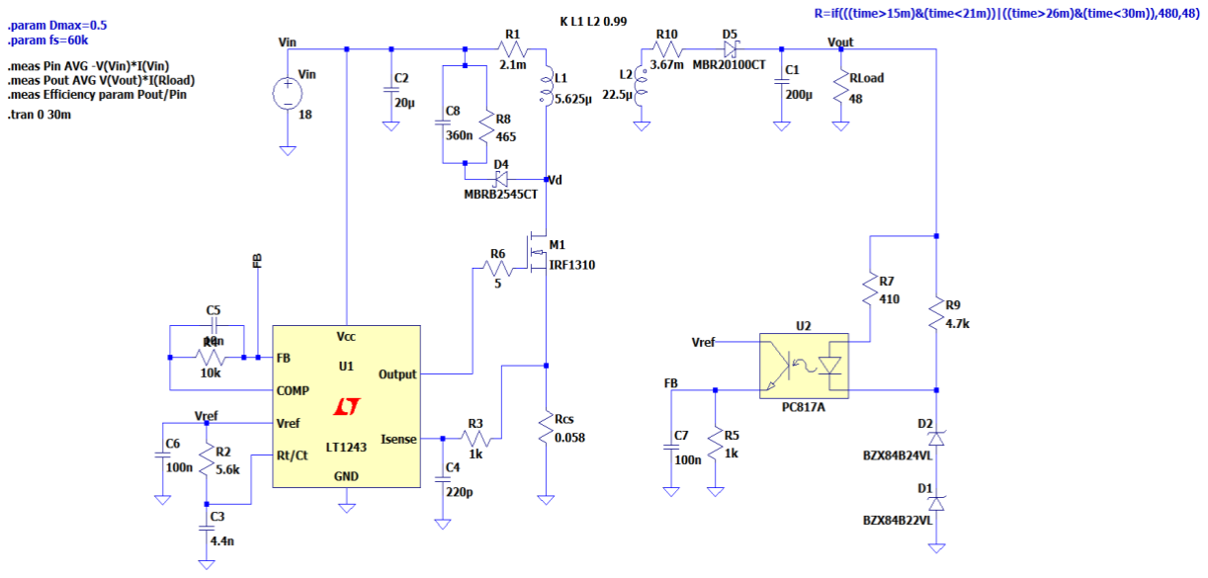
[picture p27: figure]

Figure 8. Flyback Converter Scheme on LTSpice

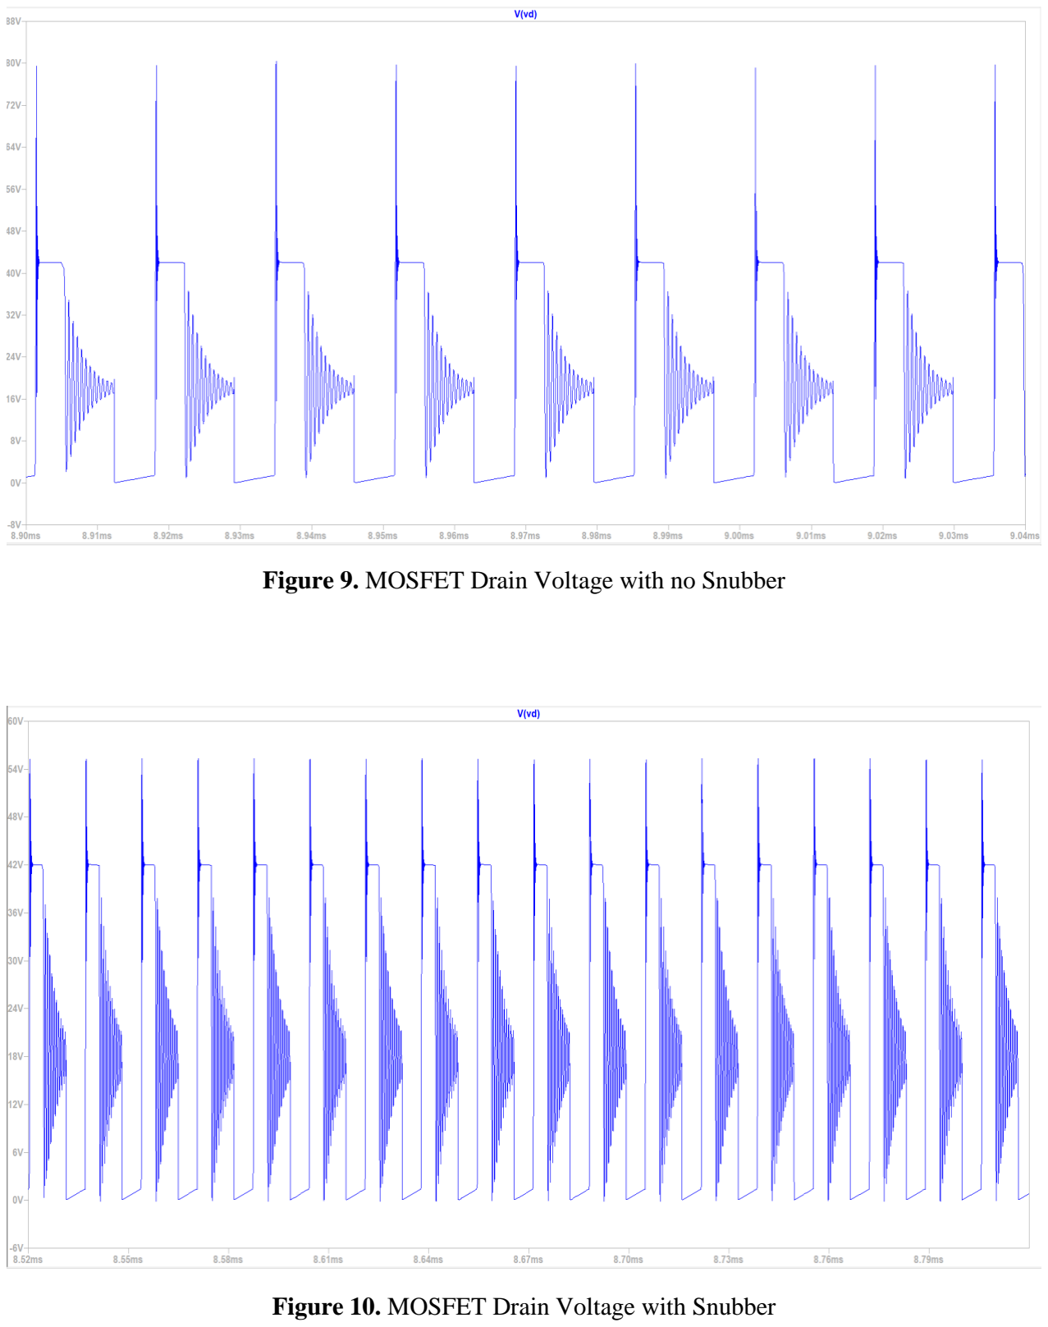
[picture p28: page 9]

Figure 9. MOSFET Drain Voltage with no Snubber

Figure 10. MOSFET Drain Voltage with Snubber

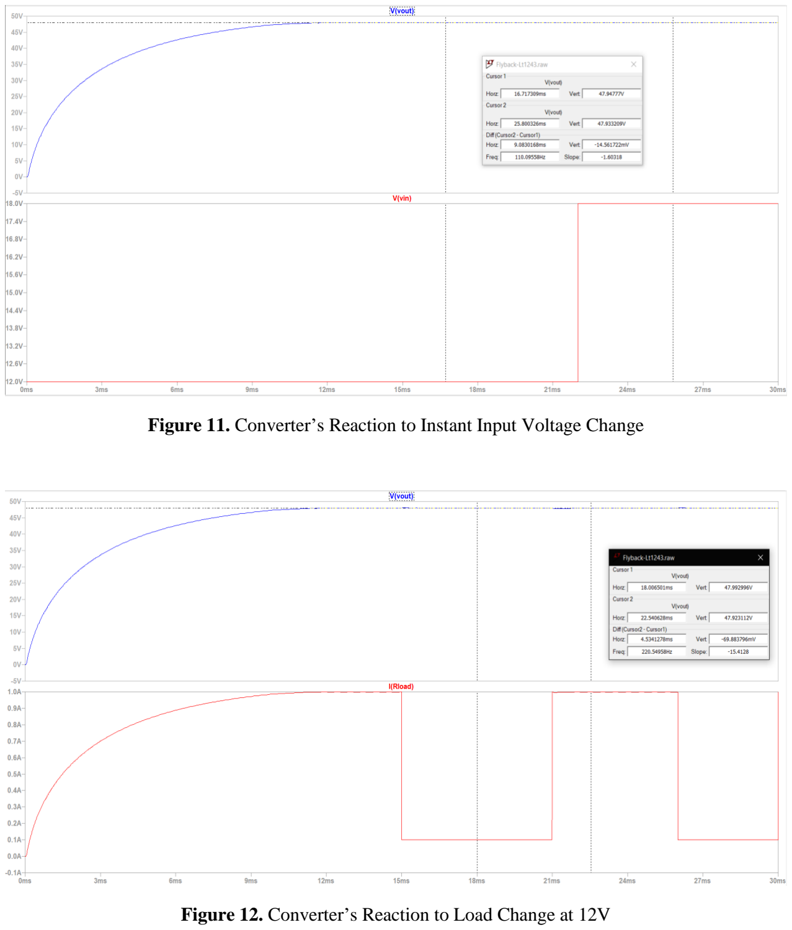
[picture p29: page 10]

Figure 11. Converter’s Reaction to Instant Input Voltage Change

Figure 12. Converter’s Reaction to Load Change at 12V

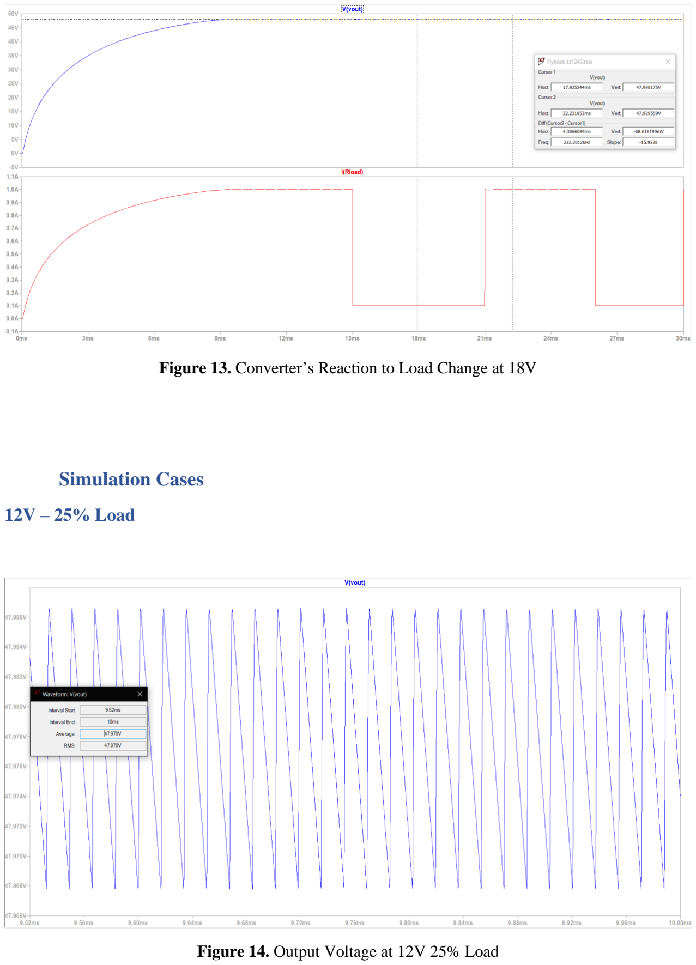
[picture p30: page 11]

Figure 13. Converter’s Reaction to Load Change at 18V

Simulation Cases

12V – 25% Load

Figure 14. Output Voltage at 12V 25% Load

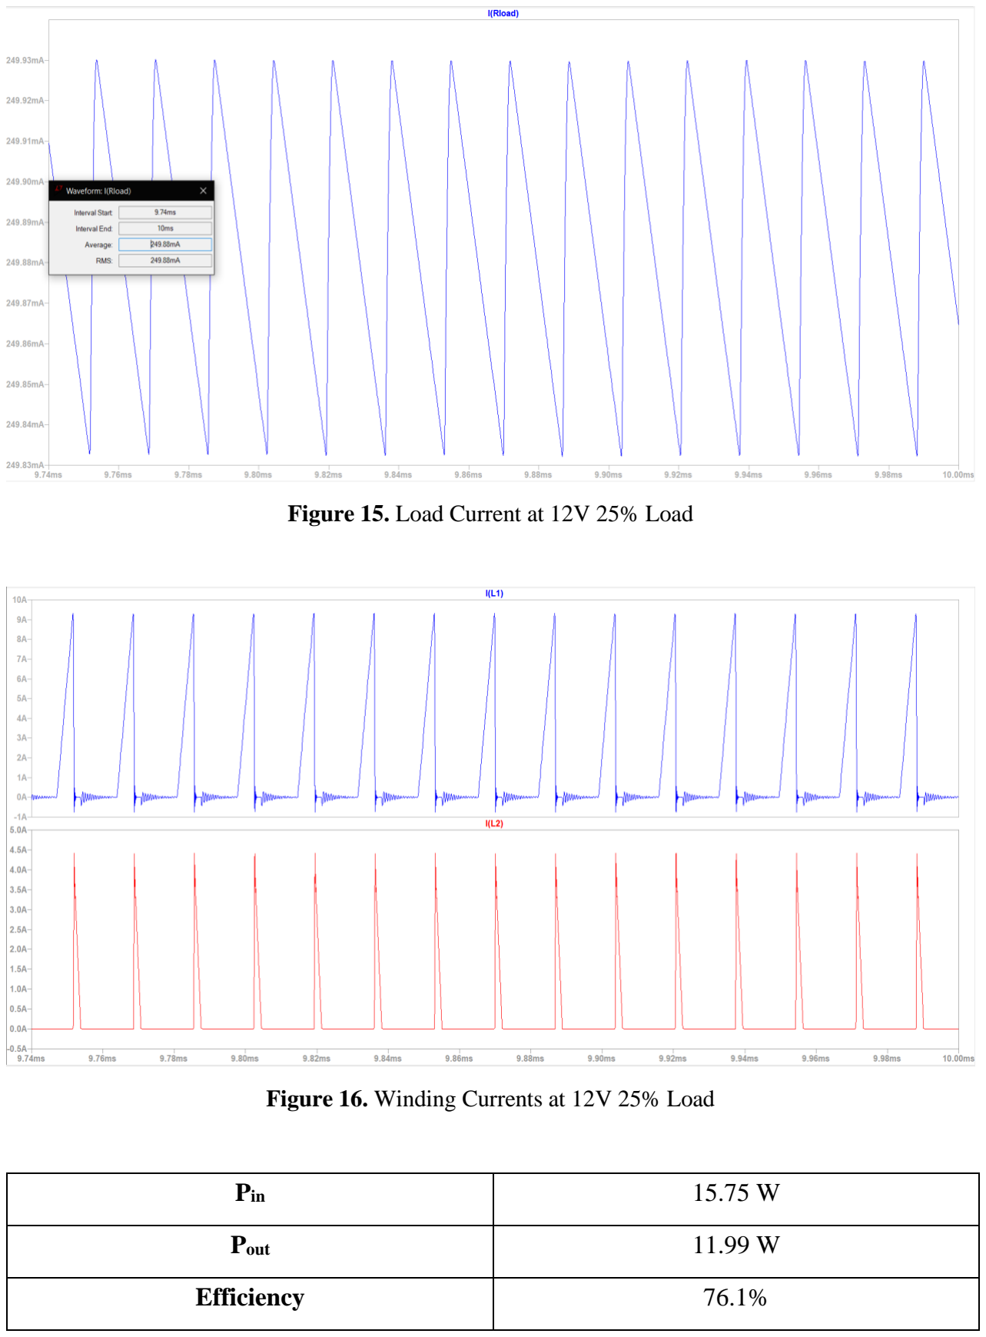
[picture p31: page 12]

Figure 15. Load Current at 12V 25% Load

Figure 16. Winding Currents at 12V 25% Load

Pin | 15.75 W
Pout | 11.99 W
Efficiency | 76.1%

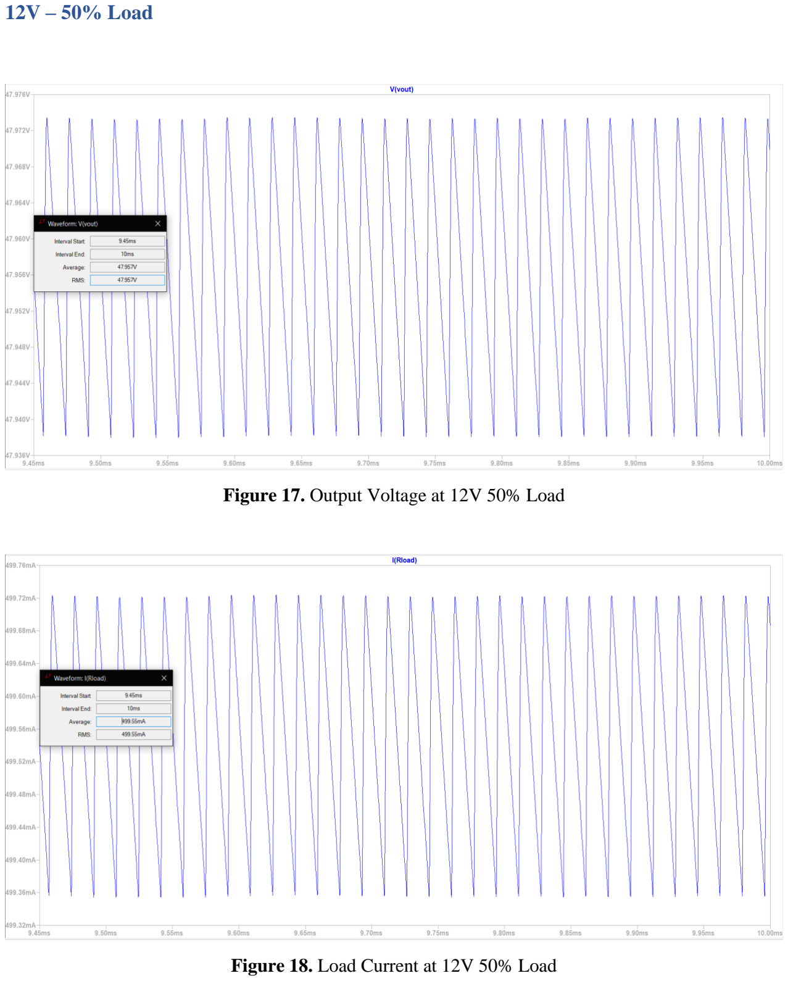
[picture p32: page 13]

12V – 50% Load

Figure 17. Output Voltage at 12V 50% Load

Figure 18. Load Current at 12V 50% Load

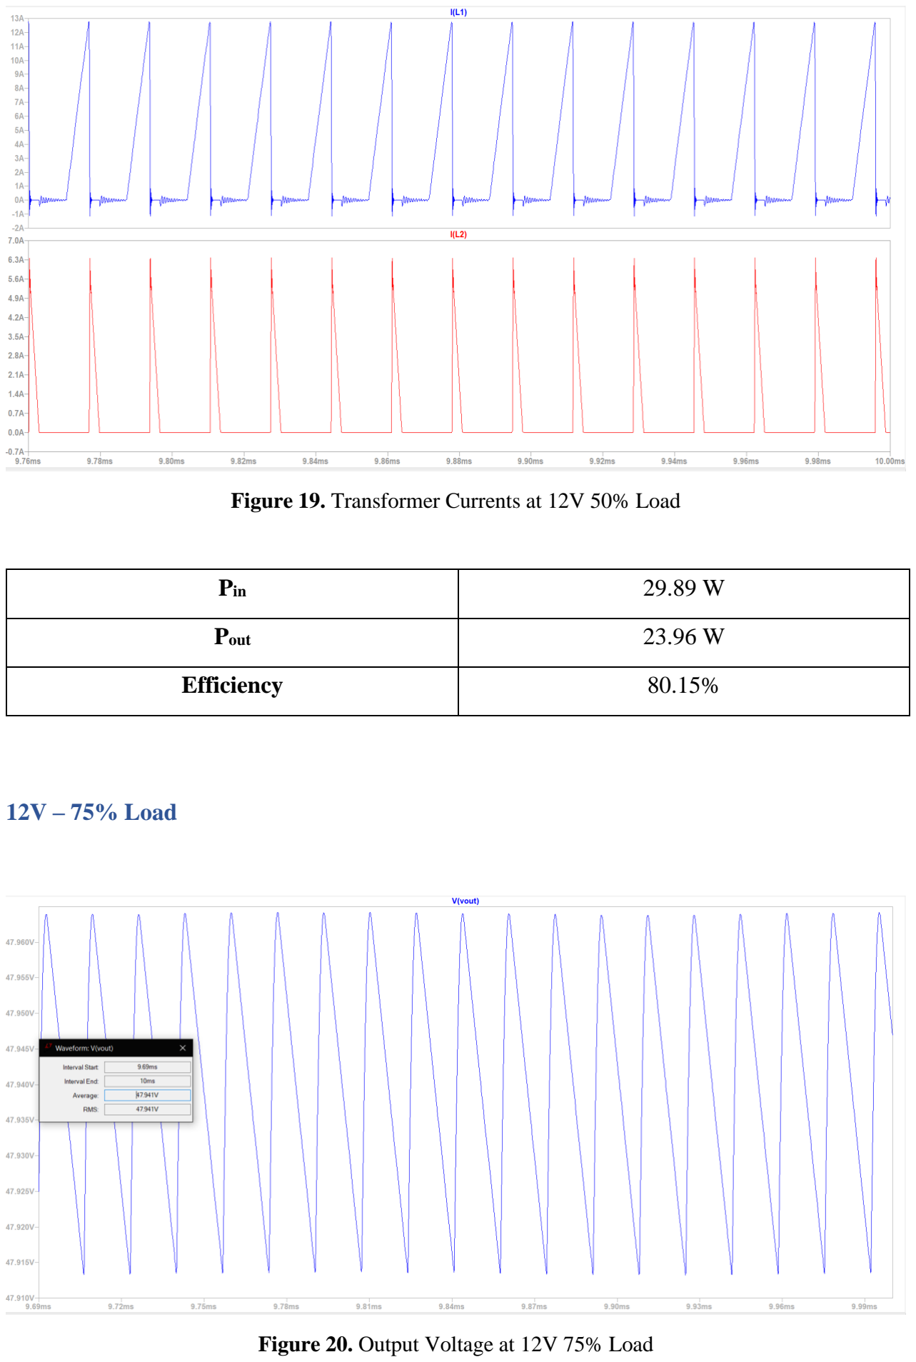
[picture p33: page 14]

Figure 19. Transformer Currents at 12V 50% Load

Pin | 29.89 W
Pout | 23.96 W
Efficiency | 80.15%

12V – 75% Load

Figure 20. Output Voltage at 12V 75% Load

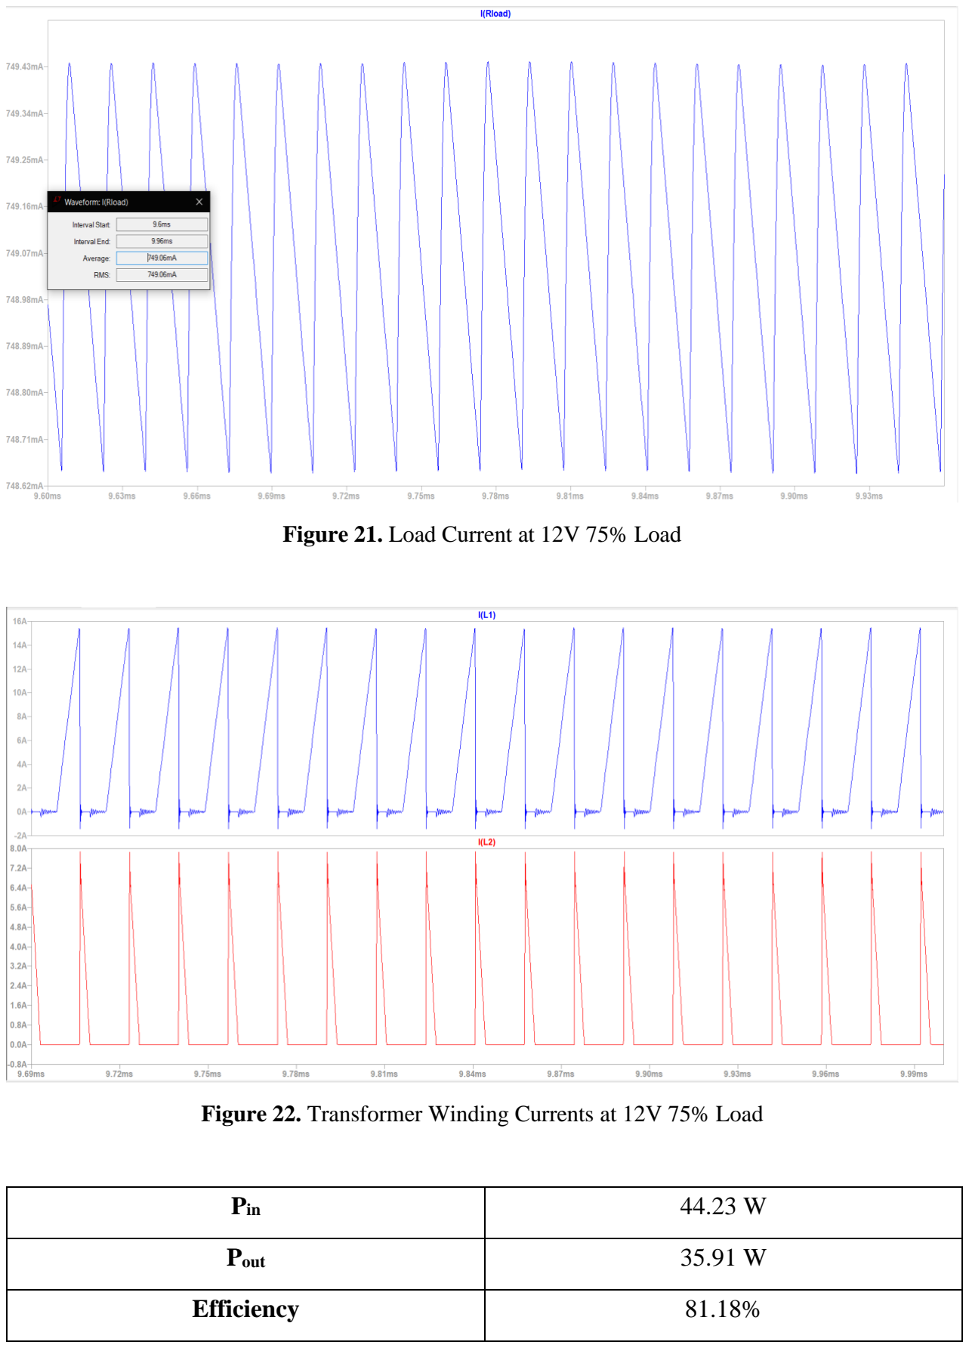
[picture p34: page 15]

Figure 21. Load Current at 12V 75% Load

Figure 22. Transformer Winding Currents at 12V 75% Load

Pin | 44.23 W
Pout | 35.91 W
Efficiency | 81.18%

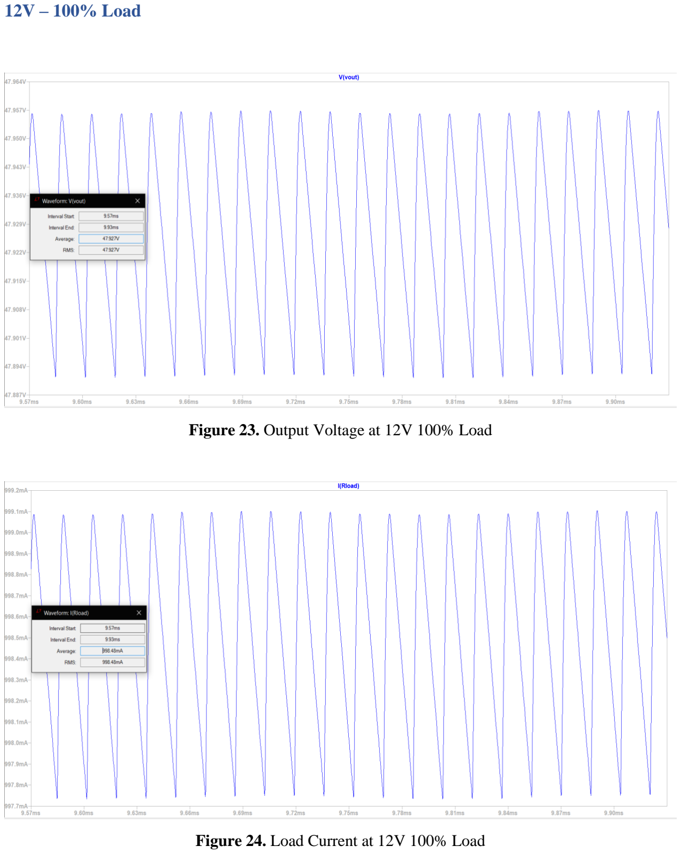
[picture p35: page 16]

12V – 100% Load

Figure 23. Output Voltage at 12V 100% Load

Figure 24. Load Current at 12V 100% Load

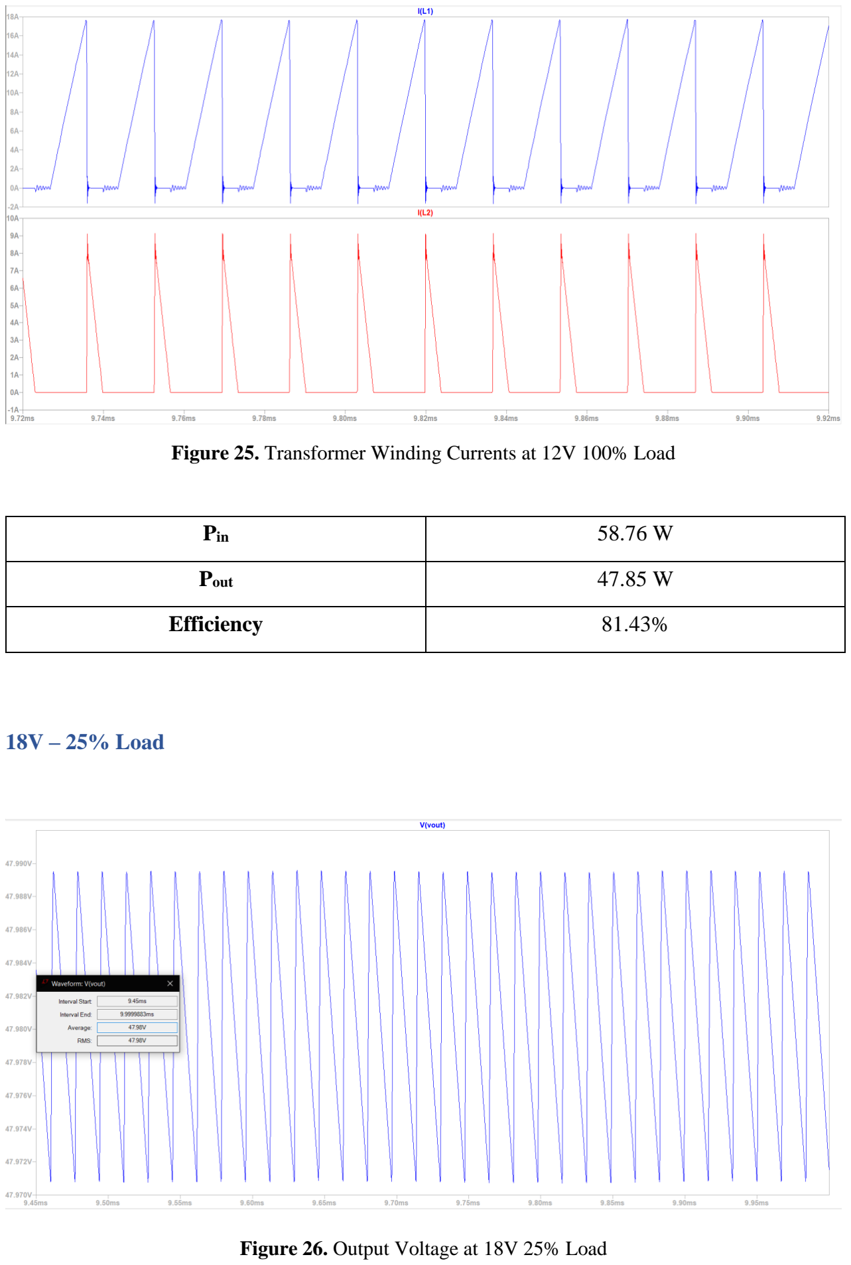
[picture p36: page 17]

Figure 25. Transformer Winding Currents at 12V 100% Load

Pin | 58.76 W
Pout | 47.85 W
Efficiency | 81.43%

18V – 25% Load

Figure 26. Output Voltage at 18V 25% Load

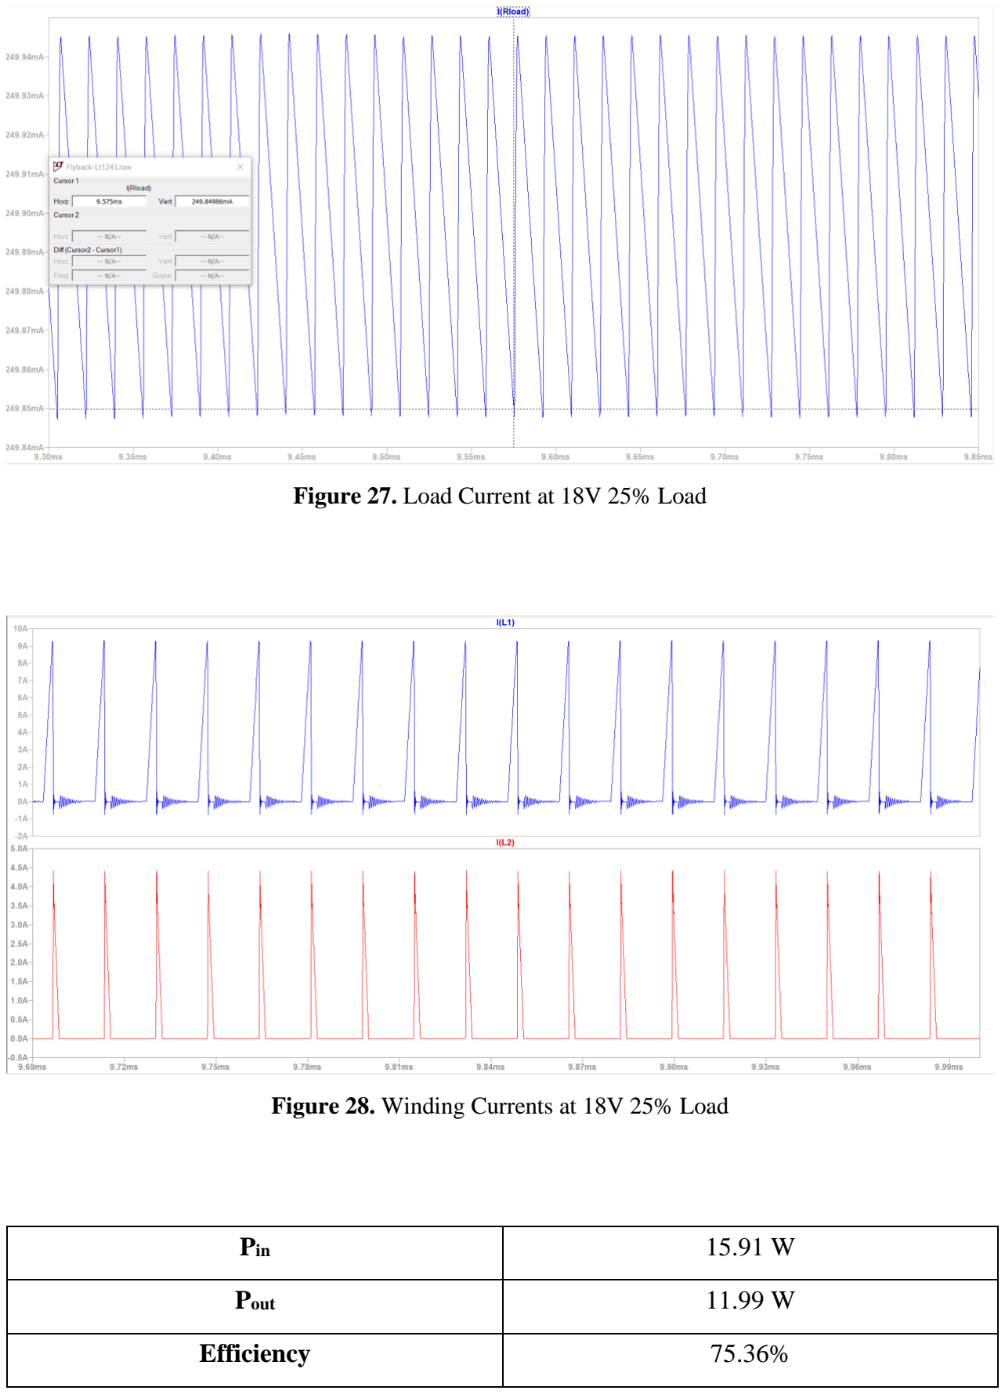
[picture p37: page 18]

Figure 27. Load Current at 18V 25% Load

Figure 28. Winding Currents at 18V 25% Load

Pin | 15.91 W
Pout | 11.99 W
Efficiency | 75.36%

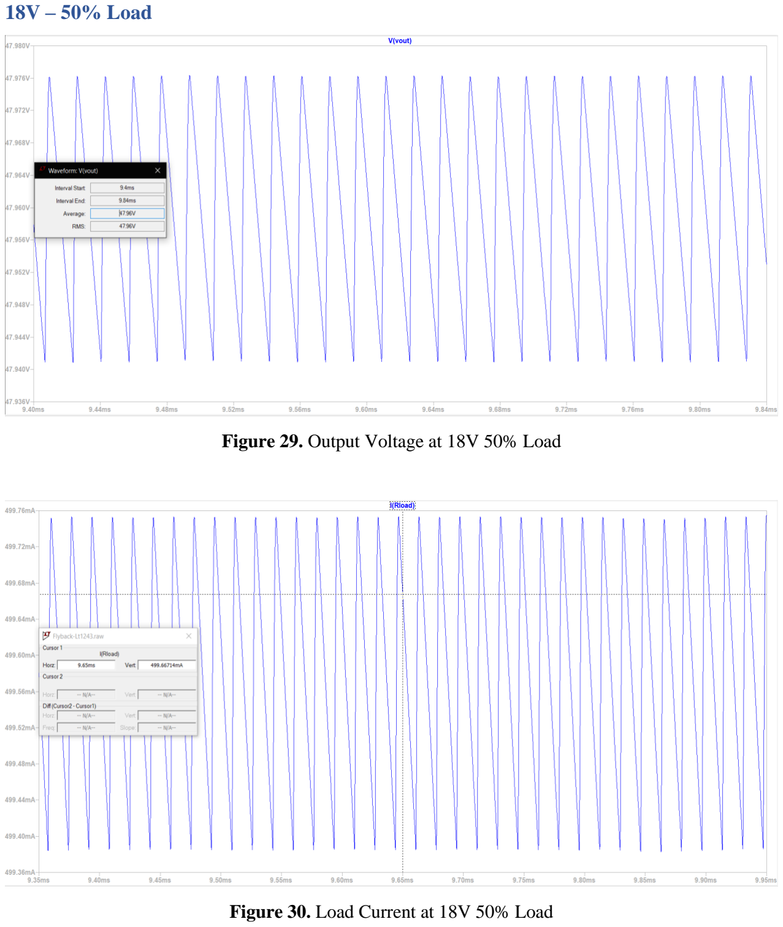
[picture p38: page 19]

18V – 50% Load

Figure 29. Output Voltage at 18V 50% Load

Figure 30. Load Current at 18V 50% Load

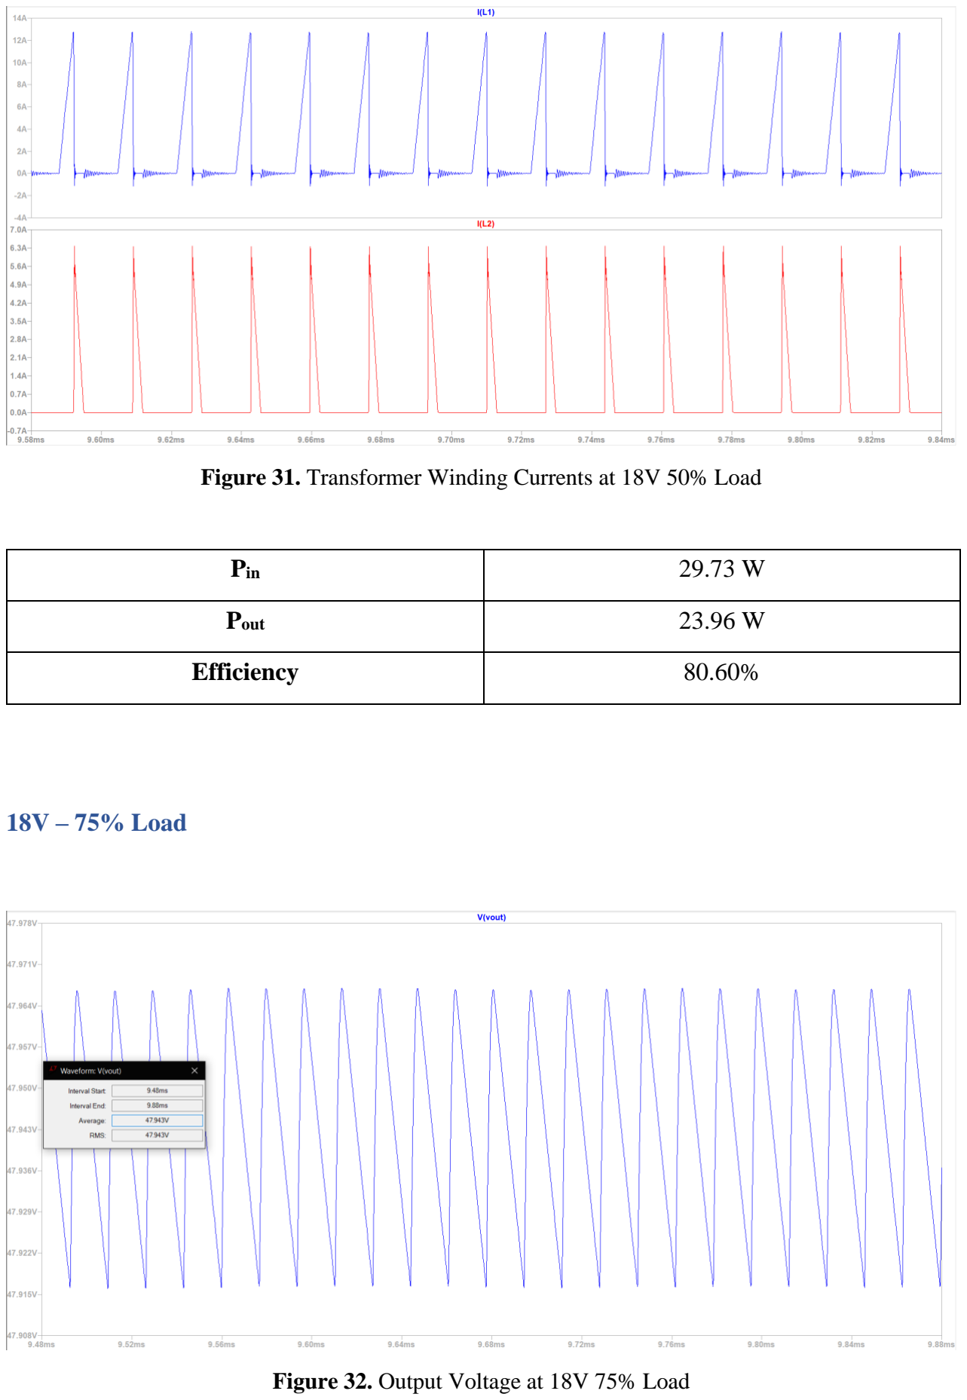
[picture p39: page 20]

Figure 31. Transformer Winding Currents at 18V 50% Load

Pin | 29.73 W
Pout | 23.96 W
Efficiency | 80.60%

18V – 75% Load

Figure 32. Output Voltage at 18V 75% Load

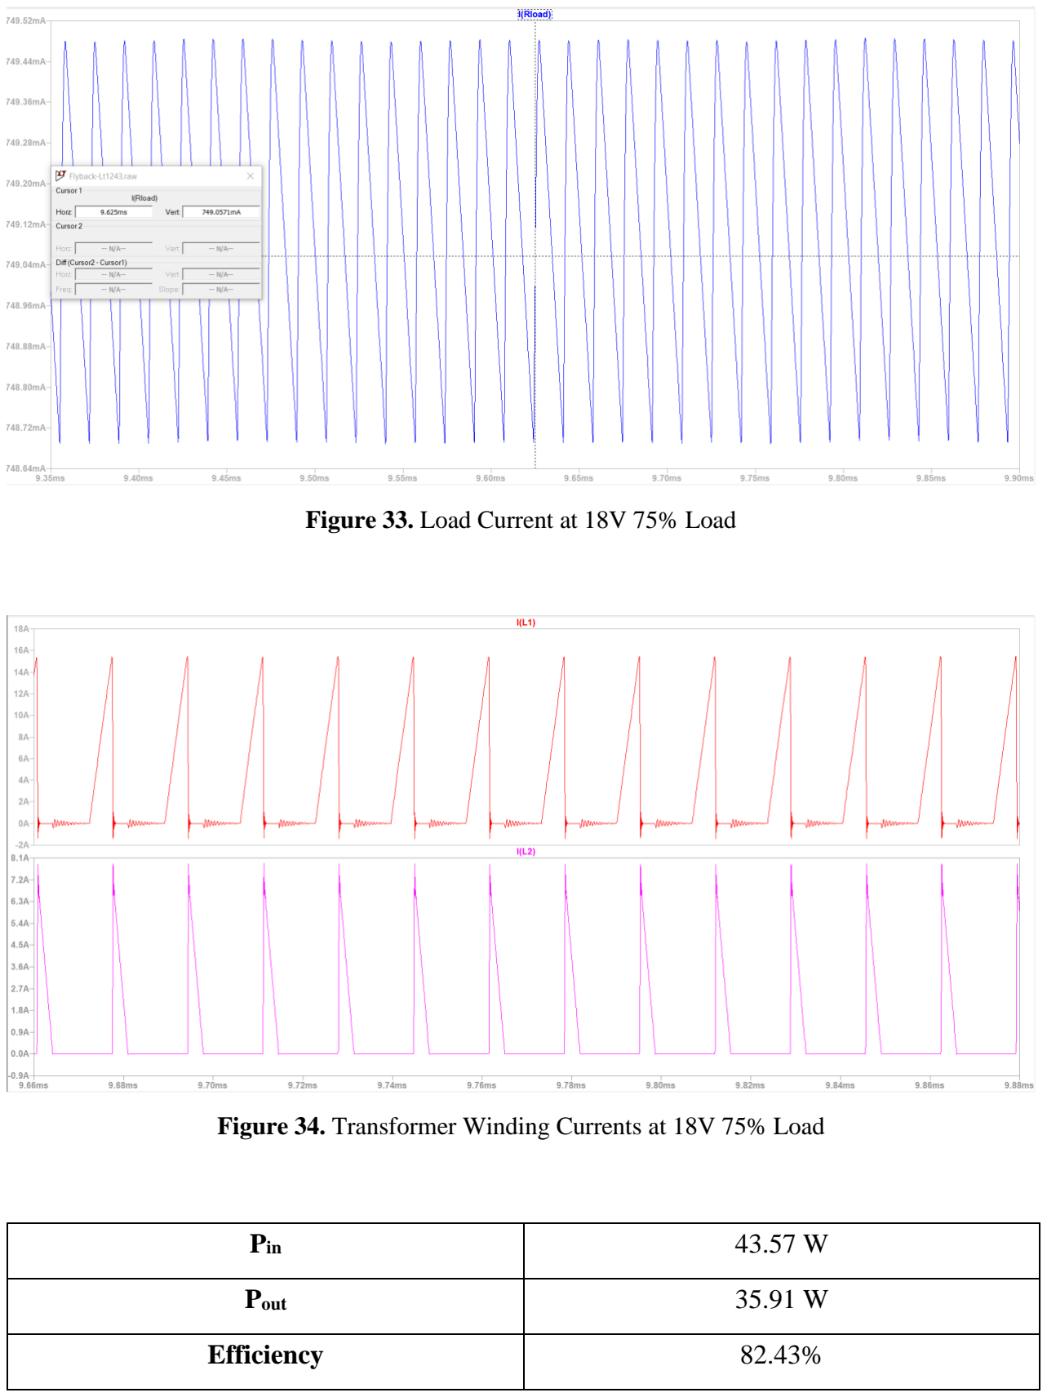
[picture p40: page 21]

Figure 33. Load Current at 18V 75% Load

Figure 34. Transformer Winding Currents at 18V 75% Load

Pin | 43.57 W
Pout | 35.91 W
Efficiency | 82.43%

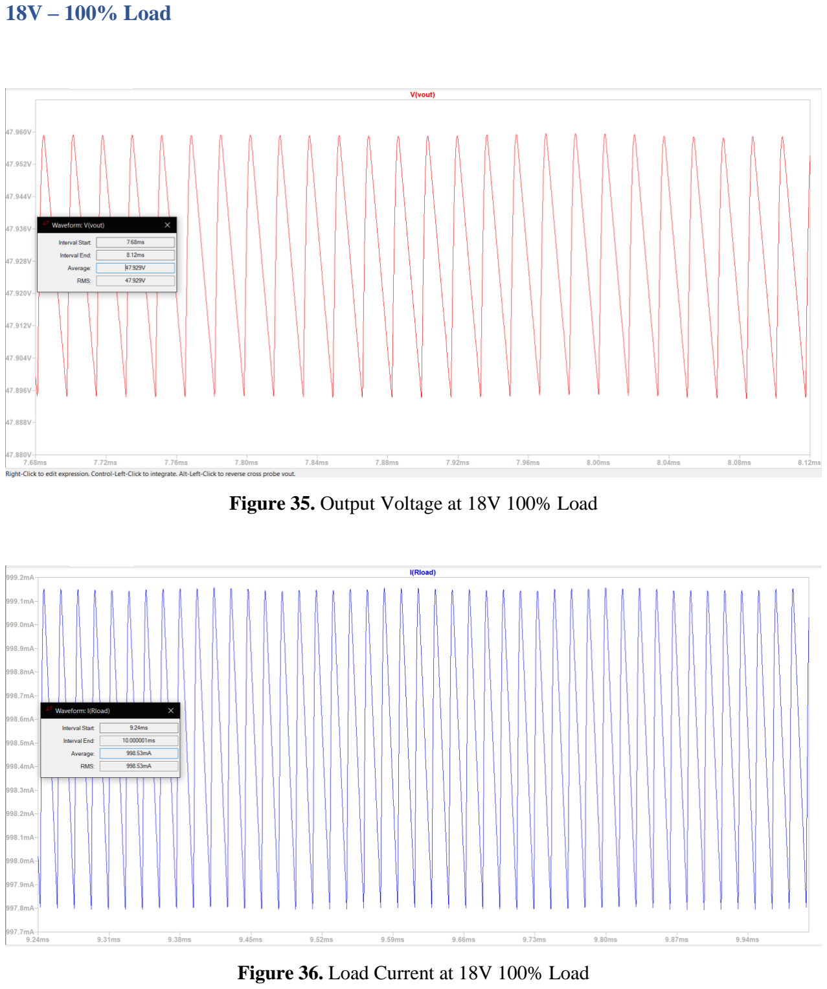
[picture p41: page 22]

18V – 100% Load

Figure 35. Output Voltage at 18V 100% Load

Figure 36. Load Current at 18V 100% Load

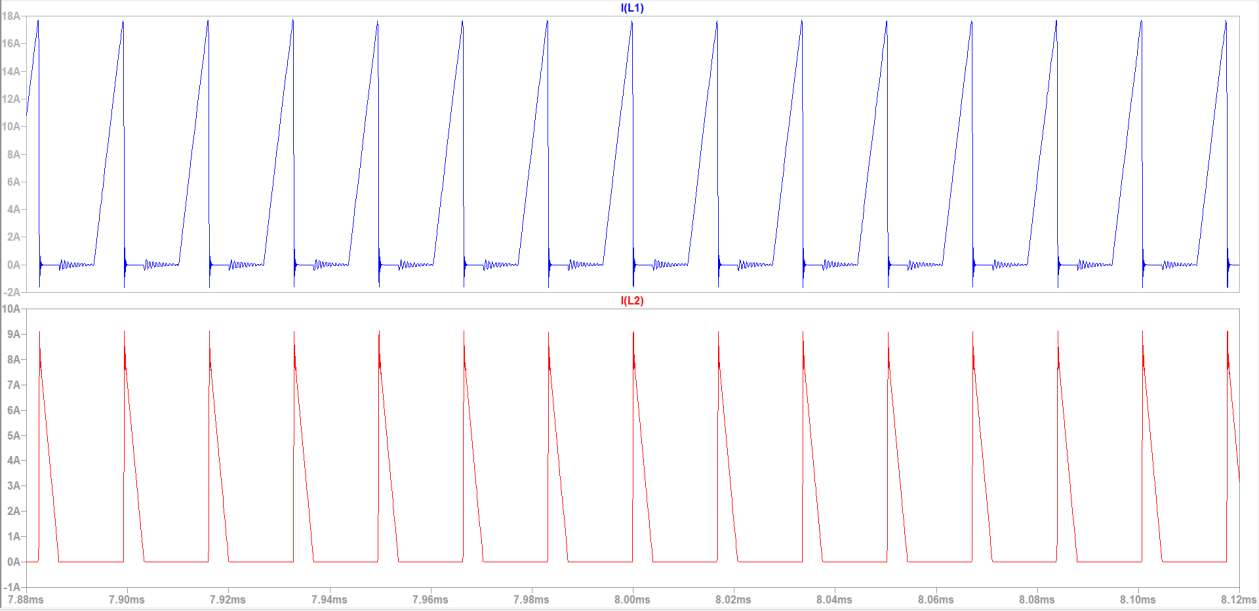
[picture p42: figure]

Figure 37. Transformer Winding Currents at 18V 100% Load

Pin | 57.44 W
Pout | 47.86 W
Efficiency | 83.31%
