ahmetfurkangursoy/EE464-TermProject/karkas-00K4022E090.stl

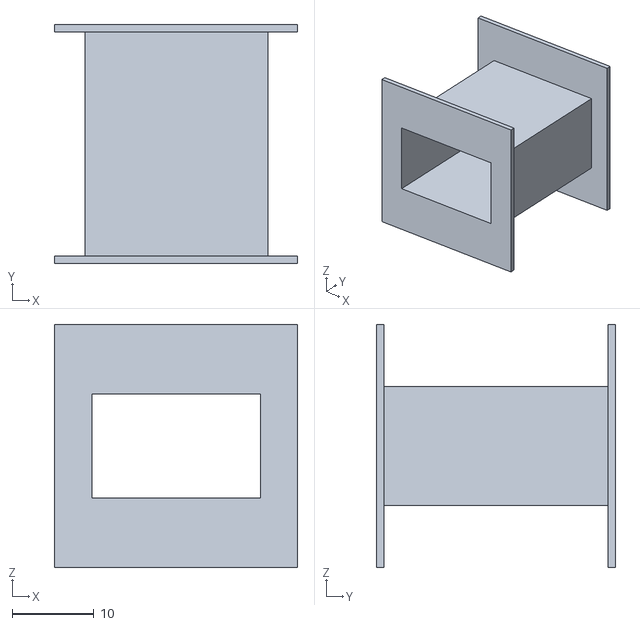
[picture p43: CAD file, 2023-06-27]
karkas-00K4022E090.stl
29.7 x 29.2 x 29.7
