ahmetfurkangursoy/EE464-TermProject/karkas-00K3515E090.stl

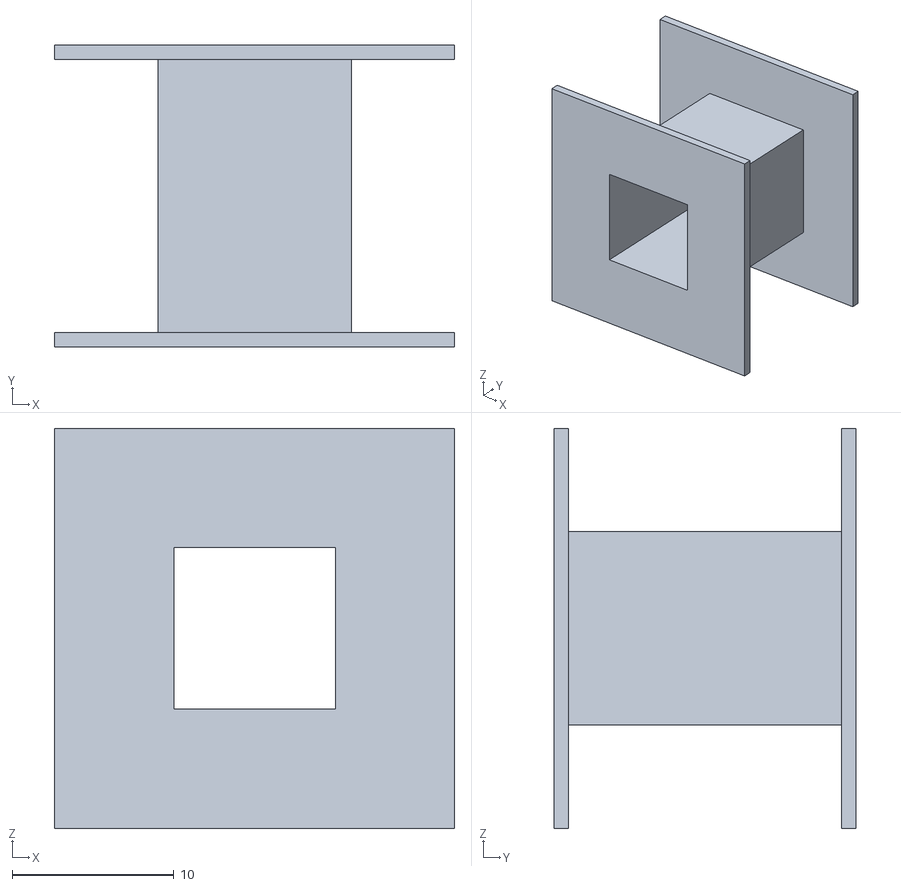
[picture p44: CAD file, 2023-06-27]
karkas-00K3515E090.stl
24.8 x 18.7 x 24.8
