ahmetfurkangursoy/EE464-TermProject/Flyback-Lt1243.asc

C1: cap; 200µ
C2: cap; 100µ
C3: cap; 4.4n
C4: cap; 220p
C5: cap; 10n
C6: cap; 100n
C7: cap; 100n
C8: cap; 22n
C9: cap; 470n
D1: zener; BZX84B22VL
D2: zener; BZX84B24VL
D4: zener; BZX84B18VL
D5: schottky; MBR20100CT
D6: schottky; MBR20100CT
L1: ind2; 6µ
L2: ind2; 23.9µ
L3: ind; 390n
M1: nmos; IRFP250N
R1: res; 3.76m
R2: res; 5.6k
R3: res; 1k
R4: res; 10k
R5: res; 1k
R6: res; 15
R7: res; 430
R8: res; 10k
R9: res; 4.7k
R10: res; 13.17m
R12: res; 1k
R13: res; 100k
Rcs: res; 0.05
RLoad1: res; 10k
RLoad: res; 48
U1: LT1243
U2: PC817A
Vin: voltage; 18
Named nets: 0, Vout, FB, Vref, Vd, Vin
K L1 L2 1
.param Dmax=0.5
.param fs=60k
.tran 0 30m 20m
R=if(((time>15m)&(time<21m))|((time>26m)&(time<30m)),480,48)
.meas Pin AVG -V(Vin)*I(Vin)
.meas Pout AVG V(Vout)*I(Rload)
.meas Efficiency param Pout/Pin
