ahmetfurkangursoy/EE464-TermProject/Flyback-CCM.asc

C1: cap; 100µ
C2: cap; 20µ
D1: schottky; RB058L150
I1: current; 1
L1: ind2; 200µ
L2: ind2; 450µ
M1: nmos; IPA086N10N3
R1: res; 48
V1: voltage; 12
V2: voltage; PULSE(0 10 0 1n 1n {D/fs} {1/fs})
Named nets: 0
.tran 0 30m 10m
K L1 L2 1
.param D = 0.73
.param fs = 300k
