ahmetfurkangursoy/EE464-TermProject/Flyback-DCM.asc

C1: cap; 50µ
C2: cap; 20µ
D1: schottky; RB058L150
I1: current; 1
L1: ind2; 3.42µ
L2: ind2; 7µ
M1: nmos; IRF1310
R1: res; 48
V1: voltage; 12
V2: voltage; PULSE(0 10 0 1n 1n {D/fs} {1/fs} )
Named nets: 0
.tran 20m
K L1 L2 1
.param D=0.613
.param fs = 150k
