ahmetfurkangursoy/EE464-TermProject/(list of files, drawings)

Other design files:
PCB/DCM_Flyback.PcbDoc
PCB/DCM_Flyback.PrjPcb
PCB/DCM_Flyback.SchDoc
PCB/Flyback_lib.PcbLib
PCB/Flyback_lib.SchLib
