ahmetfurkangursoy/EE464-TermProject/(commit log)

2023-06-27 Final Circuit Simulation File
2023-06-27 Coil Formers
    Coil former files for two cores in the lab
    [karkas-00K3515E090.stl, karkas-00K4022E090.stl]
2023-06-27 Create PCB
2023-06-27 Update and rename PCB to PCB.m
2023-06-27 Update and rename PCB.m to PCB
